ard4kocabiyik/kocapilot-kapgan-multi-domain-FCU/Docs/Kocapilot_Kapgan_SCH_Raporu.pdf

# Kocapilot Kapgan PCB Donanım Mimarisi, Sinyal Bütünlüğü, Matematiksel İspatlar, Komponent Analizi ve Şematik Düzeyde EMI/EMC Değerlendirme Raporu

Özet (Abstract) — Bu akademik teknik rapor; STM32F405RGT6 (U3) ana mikrodenetleyicisi [1], (https://www.st.com/resource/en/datasheet/dm00037051.pdf) [2] (https://www.st.com/resource/ja/reference_manual/dm00031020.pdf) ve Raspberry Pi Zero W (J1) yardımcı işlemci modülü [6], (https://www.raspberrypi.com/products/raspberry-pi-zero-w/) [7] (https://www.raspberrypi.org/app/uploads/2012/02/BCM2835-ARM-Peripherals.pdf) etrafında şekillenen gömülü uçuş/kontrol kartının donanım mimarisini, mantık seviyesi (logic level) uyumunu, sinyal bütünlüğü (Signal Integrity - SI) hesaplamalarını, birinci dereceden RC zaman sabiti ve yükselme süresi (tr

) matematiksel formül ispatlarını, pasif/aktif komponent seçim gerekçelerini ve şematik düzeyde elektromanyetik uyumluluk (EMI/EMC) ile elektrostatik deşarj (ESD) koruma
mimarisini | bütüncül | bir | mühendislik | perspektifiyle
incelemektedir. Tüm teknik iddialar, üretici veri sayfaları (datasheets), uygulama notları (application notes) ve uluslararası standartlarla IEEE numaralı atıf sistemine göre doğrulanmıştır.
I. Yönetici Özeti ve Sistem Mimarisi
Bu | teknik | rapor; | STM32F405RGT6 | (U3) | ana
mikrodenetleyicisi ve Raspberry Pi Zero W (J1) yardımcı işlemci modülü etrafında şekillenen gömülü kontrol kartının donanım mimarisini, sinyal bütünlüğü (Signal Integrity)
hesaplamalarını, | matematiksel | formül | ispatlarını,
elektromanyetik uyumluluk (EMI/EMC) önlemlerini ve komponent seçim gerekçelerini incelemektedir [1], (https://www.st.com/resource/en/datasheet/dm00037051.pdf) [2]. (https://www.st.com/resource/ja/reference_manual/dm00031020.pdf) Sistem; BMI270 (U1) 6-eksen eylemsel ölçüm birimi (SPI1) [8], (https://www.bosch-sensortec.com/media/boschsensortec/downloads/datasheets/bst-bmi270-ds000.pdf) MPU-6500 (U2) 6-eksen eylemsel ölçüm birimi (SPI2) [9], (https://product.tdk.com/en/search/sensor/mortion-inertial/imu/info?part_no=MPU-6500) MicroSD Kart Arayüzü (J5 - SPI3) [12], (https://users.ece.utexas.edu/~valvano/EE345M/SD_Physical_Layer_Spec.pdf) BMP280 (U5) barometrik basınç sensörü (I2C1) [10], (https://www.bosch-sensortec.com/media/boschsensortec/downloads/datasheets/bst-bmp280-ds001.pdf) SN65HVD230 (U8) CAN veriyolu alıcı-vericisi [14], (https://www.danomsk.ru/upload/iblock/507/129640_88c1a087ef01c473a9fb6655ddb2a31a.pdf) 74LVC1G86 (U7) kontrollü sinyal tersleyici [17] (https://assets.nexperia.com/documents/data-sheet/74LVC1G86.pdf) ve 74LVC1G125 (U9, U10, U11) üç durumlu (3-state) tampon/izolatör devrelerinden [16] (https://assets.nexperia.com/documents/data-sheet/74LVC1G125.pdf) oluşmaktadır. Güç katı ise çift kaynaklı (+5V VBUS ve 5V1 harici besleme) Schottky diyot (SS34) OR-ing mimarisi [26] (https://industrialmonitordirect.com/blogs/knowledgebase/servo-motor-pwm-control-wiring-power-and-microcontroller-code) ve 1.5 A kapasiteli LD39150DT33 (U6) doğrusal regülatörü (LDO) ile beslenmektedir [13]. (https://www.st.com/resource/en/datasheet/ld39150.pdf)

II. Sinyal Uyumu, Mantık Seviyesi (Logic Level) ve Sinyal

Tersleme (Inversion) Analizi

2.1. İşlemci ve Sensörler Arası Mantık Seviyesi (Logic Level) Uyumu
Tasarımda yer alan ana işlemci STM32F405RGT6 (U3) [1], (https://www.st.com/resource/en/datasheet/dm00037051.pdf) yardımcı işlemci Raspberry Pi Zero W (J1 - BCM2835 SoC) [6], (https://www.raspberrypi.com/products/raspberry-pi-zero-w/) [7] (https://www.raspberrypi.org/app/uploads/2012/02/BCM2835-ARM-Peripherals.pdf) ve tüm sensör/çevre birimleri (BMI270 [8], (https://www.bosch-sensortec.com/media/boschsensortec/downloads/datasheets/bst-bmi270-ds000.pdf) MPU-6500 [9], (https://product.tdk.com/en/search/sensor/mortion-inertial/imu/info?part_no=MPU-6500) BMP280 [10], (https://www.bosch-sensortec.com/media/boschsensortec/downloads/datasheets/bst-bmp280-ds001.pdf) SN65HVD230 [14], (https://www.danomsk.ru/upload/iblock/507/129640_88c1a087ef01c473a9fb6655ddb2a31a.pdf) MicroSD J5 [12]) (https://users.ece.utexas.edu/~valvano/EE345M/SD_Physical_Layer_Spec.pdf) 3.3V CMOS mantık seviyesinde (VDD = VDDIO = 3.3 V) çalışmaktadır. Her bir entegrenin giriş/çıkış voltaj eşikleri karşılaştırıldığında:
STM32F405RGT6 (U3, VDD = 3.3V): Maksimum düşük seviye giriş gerilimi VIL(max) = 0.3 × VDD = 0.99 V; minimum yüksek seviye giriş gerilimi VIH(min) = 0.7 × VDD = 2.31 V; maksimum düşük seviye çıkış gerilimi VOL(max) =

0.4 V; minimum yüksek seviye çıkış gerilimi VOH(min) = VDD − 0.4 V = 2.9 V [1]. (https://www.st.com/resource/en/datasheet/dm00037051.pdf)
BMI270 (U1, VDDIO = 3.3V): VIL(max) = 0.3 × VDDIO = 0.99 V; VIH(min) = 0.7 × VDDIO = 2.31 V; VOL(max) = 0.2 × VDDIO = 0.66 V; VOH(min) = 0.8 × VDDIO = 2.64 V [8]. (https://www.bosch-sensortec.com/media/boschsensortec/downloads/datasheets/bst-bmi270-ds000.pdf) MPU-6500 (U2, VDDIO = 3.3V): VIL(max) = 0.3 × VDDIO = 0.99 V; VIH(min) = 0.7 × VDDIO = 2.31 V; VOL(max) = 0.1 × VDDIO = 0.33 V; VOH(min) = 0.9 × VDDIO = 2.97 V [9]. (https://product.tdk.com/en/search/sensor/mortion-inertial/imu/info?part_no=MPU-6500) BMP280 (U5, VDDIO = 3.3V): VIL(max) = 0.2 × VDDIO = 0.66 V; VIH(min) = 0.8 × VDDIO = 2.64 V; VOL(max) = 0.2 × VDDIO = 0.66 V; VOH(min) = 0.8 × VDDIO = 2.64 V [10]. (https://www.bosch-sensortec.com/media/boschsensortec/downloads/datasheets/bst-bmp280-ds001.pdf)
Tüm sensörlerin VOH(min) değerleri (2.64 V – 2.97 V), işlemcinin VIH(min) eşiğinden (2.31 V) büyüktür ve en az 0.33 V yüksek seviye gürültü marjı (NMH = VOH(min) − VIH(min)) sağlar. Benzer şekilde VOL(max) değerleri (0.33 V – 0.66 V), alıcı VIL(max) eşiklerinin (0.66 V – 0.99 V) altındadır. Bu teknik uyum sebebiyle işlemci ile sensörler arasında gerilim seviyesi dönüştürücüye (level shifter) ihtiyaç duyulmamaktadır [1], (https://www.st.com/resource/en/datasheet/dm00037051.pdf) [8]– (https://www.bosch-sensortec.com/media/boschsensortec/downloads/datasheets/bst-bmi270-ds000.pdf) [10]. (https://www.bosch-sensortec.com/media/boschsensortec/downloads/datasheets/bst-bmp280-ds001.pdf)
2.2. Sinyal Tersleme (Inversion) Değerlendirmesi ve Gerekçelendirilmesi
A. Sensör, SPI, I2C, CAN ve Kesme (Interrupt) Hatları: Sinyal Terslemeye Gerek Yoktur
İşlemci (STM32F405RGT6) ile sensörler (BMI270, MPU-6500, BMP280), MicroSD (J5) ve CAN (U8) birimleri arasındaki SPI1, SPI2, SPI3, I2C1, CAN1 ve kesme (INT1, INT2, MPU_INT) hatlarında sinyal terslemeye gerek yoktur. Gerekçeleri şunlardır:
1. SPI | Polarite | ve | Faz | Uyumu | (CPOL/CPHA):
STM32F405RGT6 donanımsal SPI birimleri hem Mod 0 (CPOL = 0, CPHA = 0) hem de Mod 3 (CPOL = 1, CPHA = 1) saat polaritesini doğrudan destekler [2]. (https://www.st.com/resource/ja/reference_manual/dm00031020.pdf) Aktif-düşük (Active-Low) çalışan çip seçme pinleri (CSB, nCS, SD_NSS) işlemci GPIO pinleri tarafından doğrudan Lojik-0 seviyesine çekilerek sürülür ve R1, R5, R15, R66 (10 kΩ) pull-up dirençleri ile boşta Lojik-1 seviyesinde tutulur.
2. Kesme (Interrupt) Polaritesi: BMI270 (INT1, INT2) [8] (https://www.bosch-sensortec.com/media/boschsensortec/downloads/datasheets/bst-bmi270-ds000.pdf) ve MPU-6500 (INT) [9] (https://product.tdk.com/en/search/sensor/mortion-inertial/imu/info?part_no=MPU-6500) kesme çıkışları yazılımsal olarak
Aktif-Yüksek | (Active-High, | Push-Pull) | modda
yapılandırılmakta ve R4, R10, R19 (10 kΩ) pull-down
dirençleri | ile | boşta | Lojik-0 | (0 | V) | seviyesinde
sabitlenmektedir. STM32 EXTI birimi yükselen kenar (rising edge) tetiklemesine doğrudan duyarlı olduğundan harici sinyal terslemeye gerek yoktur [2]. (https://www.st.com/resource/ja/reference_manual/dm00031020.pdf)
3. I2C1 ve CAN1 Protokol Uyumu: BMP280 ile haberleşen I2C1 hattı açık-drenaj (open-drain) yapısında olup R8 ve R9 (2.2 kΩ) pull-up dirençleriyle doğrudan standart I2C mantığında çalışır [11]. SN65HVD230 CAN alıcı-vericisi ise resesif durumu Lojik-1 (3.3 V), dominant durumu Lojik-0 (0 V) olarak STM32 CAN1_TX / CAN1_RX donanımıyla birebir aynı polaritede işler [14].
B. Uzaktan Kumanda Girişi (RC_IN_UART) ve Tampon Yetkilendirme (OE) Hatları: Sinyal Terslemeye Gerek Vardır
1. RC_IN Hattında Kontrollü Tersleme (74LVC1G86 - U7 ve JP2): STM32F405RGT6 mimarisinde bulunan donanımsal UART alıcıları (PD2 / UART5_RX), dahili pin tersleme (hardware RX pin inversion) özelliğine sahip değildir [2]. (https://www.st.com/resource/ja/reference_manual/dm00031020.pdf) Standart UART protokolleri (CRSF, IBUS) boşta Lojik-1 (Idle-High) çalışırken, Futaba SBUS protokolü terslenmiş mantık (Inverted UART, boşta Lojik-0 / Idle-Low) kullanır. Bu donanımsal kısıt sebebiyle RC_IN hattında sinyal terslemeye gerek vardır. Çözüm olarak 74LVC1G86 (U7) tekli XOR kapısı [17] (https://assets.nexperia.com/documents/data-sheet/74LVC1G86.pdf) ve JP2 lehim jumper'ı kullanılmıştır. XOR doğruluk tablosuna göre (Y = A ⊕ B):
› JP2 üzerinden 1B girişi (Pin 2) Lojik-0 (GND) seviyesine bağlandığında: Y = A ⊕ 0 = A (Sinyal terslenmeden tampon olarak geçer; CRSF/IBUS uyumlu). › JP2 açık bırakılarak R30 (10 kΩ) pull-up direnciyle 1B girişi Lojik-1 (3.3 V) seviyesine çekildiğinde: Y = A ⊕ 1 = NOT(A) (Sinyal donanımsal olarak terslenir; SBUS uyumlu).
2. Güç İzolasyonu ve Tampon Yetkilendirme Hattı (2N7002
- Q2 ve 74LVC1G125 - U9): Raspberry Pi Zero W modülünün 3.3V besleme hattı (PI_3V3) aktif olduğunda (Lojik-1), 74LVC1G125 (U9) tampon entegresinin aktif-düşük yetkilendirme pini olan OE (Pin 1) girişinin Lojik-0 (GND) seviyesine çekilmesi gerekmektedir [16]. (https://assets.nexperia.com/documents/data-sheet/74LVC1G125.pdf) Aktif-yüksek güç varlık sinyalini (PI_3V3 = 3.3 V) aktif-düşük yetkilendirme sinyaline (OE = 0 V) dönüştürmek için sinyal terslemeye gerek vardır. Bu işlem Q2 (2N7002 N-Kanal MOSFET) [27], (https://assets.nexperia.com/documents/data-sheet/2N7002.pdf) R80 (100 kΩ pull-up) ve R81 (100 kΩ pull-
down) | tabanlı | evirici | anahtarlama | devresi | ile
gerçekleştirilmiştir:
Raspberry Pi Zero W enerjisizken (PI_3V3 = 0 V): R81 direnci Q2 Gate ucunu 0 V'da tutar, Q2 kesimdedir (OFF). R80 direnci U9 Pin 1 (OE) ucunu 3.3V_DIGI (Lojik-1) seviyesine çeker ve U9 çıkışı yüksek empedans (Hi-Z) modunda kalarak güç bölgeleri arası ters akım sızıntısını (back-powering) önler [16]. (https://assets.nexperia.com/documents/data-sheet/74LVC1G125.pdf)
Raspberry Pi Zero W enerjili iken (PI_3V3 = 3.3 V): Q2 Gate ucu 3.3 V olur (VGS = 3.3 V > VGS(th) = 1.8 V), Q2 iletime geçer (ON) ve U9 Pin 1 (OE) ucunu GND (Lojik-
0) seviyesine çekerek UART haberleşmesini aktif hale getirir [27]. (https://assets.nexperia.com/documents/data-sheet/2N7002.pdf)

III. Sinyal Bütünlüğü (Signal Integrity), Matematiksel

Türetimler ve Hat Hesaplamaları

3.1. RC Adım Yanıtı ve %10 - %90 Yükselme Süresi (tr = 2.2 × R × C) Matematiksel İspatı
Seri direnç (R) ve paralel yük kapasitansı (C) içeren birinci dereceden bir RC ağında, t = 0 anında uygulanan Vson genlikli birim basamak (step) gerilimine karşı kapasitör uçlarındaki anlık gerilim V(t) şu diferansiyel denklem çözümüyle ifade edilir (High-Speed Digital Design / AN4879) [5]: (https://www.st.com/resource/en/application_note/an4879-introduction-to-usb-hardware-and-pcb-guidelines-using-stm32-mcus-stmicroelectronics.pdf)

V(t) = Vson × (1 − e

−t / (R × C))
Burada zaman sabiti τ = R × C'dir. Sinyalin son değerinin %10'una (0.1 × Vson) ulaştığı an t1 ve %90'ına (0.9 × Vson) ulaştığı an t2 olarak tanımlandığında:
1. %10 Seviyesi (t1 Anı):
0.1 × Vson = Vson × (1 − e

−t1 / (R × C)) ⇒ 0.1 = 1 − e

−t1 / (R ×
C) ⇒ e

−t1 / (R × C) = 0.9
Her iki tarafın doğal logaritması (ln) alındığında:
−t1

/ (R × C) = ln(0.9) = −0.10536 ⇒ t1 = 0.10536 × R × C
2. %90 Seviyesi (t2 Anı):
0.9 × Vson = Vson × (1 − e

−t2 / (R × C)) ⇒ 0.9 = 1 − e

−t2 / (R ×
C) ⇒ e

−t2 / (R × C) = 0.1
Her iki tarafın doğal logaritması (ln) alındığında:
−t2

/ (R × C) = ln(0.1) = −2.302585 ⇒ t2 = 2.302585 × R × C
3. Yükselme Süresi (t

r = t2 − t1

):
tr = t2 − t1 = (2.302585 × R × C) − (0.10536 × R × C)
tr = R × C × (ln(10) − ln(10/9)) = R × C × ln(9)
ln(9) = 2.19722458 olup mühendislik hesaplamalarında 2.2 olarak kullanılır:
tr = 2.1972 × R × C ≈ 2.2 × R × C
3.2. SPI3 / MicroSD Kart (J5) Hattı Sinyal Bütünlüğü ve Harmonik Analizi
STM32F405RGT6 APB1 (42 MHz) veriyolu üzerinden sürülen SPI3 birimi, 2'ye bölme faktörü (prescaler = 2) ile fclk = 21 MHz saat frekansında çalışmaktadır [2], (https://www.st.com/resource/ja/reference_manual/dm00031020.pdf) [12]. (https://users.ece.utexas.edu/~valvano/EE345M/SD_Physical_Layer_Spec.pdf)
Periyot ve Darbe Genişliği:
T = 1 / fclk = 1 / (21 × 10

6 Hz) = 4.7619 × 10

−8 s = 47.62 ns
Simetrik (%50 görev döngülü) kare dalga için yarım periyot (Lojik-1 darbe genişliği):
Thalf = T / 2 = 47.62 ns / 2 = 23.81 ns
Hat Yük Kapasitansı (Cload) Bileşenleri:
Cload = Cpin (Alıcı giriş kapasitansı: 7 pF) + Ctrace (4–5 cm FR4 mikroşerit yol kapasitansı, ≈ 1 pF/cm: 5 pF) + Cconn (J5 soket ve ESD ped kapasitansı: 3 pF) = 7 pF + 5 pF + 3 pF = 15 pF (15 × 10

−12 F).
Karakteristik Empedans Eşleşmesi (Z0 = 50 Ω):
MCU Çıkış Yönü (SD_NSS → R62, SPI3_SCK → R63, SPI3_MOSI → R65): STM32 hızlı GPIO sürücü iç empedansı Rdrv = 28 Ω'dur [1]. (https://www.st.com/resource/en/datasheet/dm00037051.pdf) Rs = 22 Ω seri sönümleme direnci eklenerek toplam kaynak empedansı Ztoplam = Rdrv + Rs = 28 Ω + 22 Ω = 50 Ω değerine eşitlenmiş ve Z0 = 50 Ω PCB hattı ile tam empedans uyumu sağlanmıştır. MicroSD Kart Çıkış Yönü (J5 DAT0 → R64 → SPI3_MISO): MicroSD kart dahili sürücü çıkış empedansı Rdrv_card = 40 Ω'dur [12]. (https://users.ece.utexas.edu/~valvano/EE345M/SD_Physical_Layer_Spec.pdf) Hat empedansı Z0 = 50 Ω ile tam eşleşme sağlamak amacıyla R64 = 10 Ω seçilmiştir: Ztoplam = Rdrv_card + R64 = 40 Ω + 10 Ω = 50 Ω.
Yükselme Süresi (t
r

) ve Darbe Genişliği Oranı: tr = 2.1972 × Ztoplam × Cload = 2.1972 × 50 Ω × 15 × 10

−12
F = 1.6479 × 10

−9 s ≈ 1.65 ns
Oran = (tr

/ Thalf) × 100 = (1.65 ns / 23.81 ns) × 100 = %6.93
Yükselme süresi darbe genişliğinin %10 sınırının (%6.93 < %10) altında kaldığından kare dalga dikliği korunur ve kurulum/tutma (setup/hold) zamanlama hatası oluşmaz.

Alçak Geçiren Kesim Frekansı (f
c

) ve Fourier Harmonik
Analizi:
fc = 1 / (2 × π × Ztoplam × Cload) = 1 / (2 × 3.14159 × 50 × 15 × 10

−12) = 1 / (4.71239 × 10

−9) = 212.21 MHz
Fourier serisi açılımına göre 21 MHz kare dalganın tek harmonikleri:
1. Harmonik (Temel Frekans): 1 × 21 MHz = 21 MHz
3. Harmonik: 3 × 21 MHz = 63 MHz
5. Harmonik: 5 × 21 MHz = 105 MHz
7. Harmonik: 7 × 21 MHz = 147 MHz
9. Harmonik: 9 × 21 MHz = 189 MHz
Kesim frekansı (212.21 MHz), 9. harmoniğin (189 MHz) üzerindedir; ilk 9 harmonik zayıflamadan geçerken 212.21 MHz üstündeki yüksek frekanslı çınlama (ringing) ve aşım (overshoot) bileşenleri süzülür. Bu düzenleme sayesinde EMI/EMC direnci artırılmıştır [5]. (https://www.st.com/resource/en/application_note/an4879-introduction-to-usb-hardware-and-pcb-guidelines-using-stm32-mcus-stmicroelectronics.pdf)
3.3. SPI1 (BMI270 - U1) ve SPI2 (MPU-6500 - U2) Hatlarına Genişletilmiş Sinyal Analizi
SD kart (SPI3) hatları için uygulanan sinyal bütünlüğü modeli, kart üzerindeki noktadan noktaya (point-to-point) uzanan SPI1 ve SPI2 sensör veriyollarına genişletilmiştir:
A. SPI1 Veriyolu (STM32 PA4..PA7 ↔ BMI270 U1)
BMI270 maksimum fclk_spi1 = 10 MHz SPI saat frekansını destekler [8]. (https://www.bosch-sensortec.com/media/boschsensortec/downloads/datasheets/bst-bmi270-ds000.pdf)
Periyot ve Yarım Periyot: Tspi1 = 1 / (10 × 10

6 Hz) = 100
ns; Thalf_spi1 = 100 ns / 2 = 50 ns.
Hat Yük Kapasitansı (Cload_spi1): Konnektör içermeyen doğrudan PCB bağlantısında Cpin (BMI270/STM32: 5 pF) + Ctrace (2–3 cm kısa mikroşerit yol: 3 pF) + Cpad (2 pF) = 10 pF (10 × 10

−12 F).
Empedans, Yükselme Süresi ve Kritik Yol Uzunluğu: Doğrudan bağlantıda (Rs = 0 Ω, Rdrv = 28 Ω):
tr_spi1 = 2.1972 × Rdrv × Cload_spi1 = 2.1972 × 28 Ω × 10 × 10

−12 F = 0.615 ns ≈ 0.62 ns.
Oran = (0.62 ns / 50 ns) × 100 = %1.24 (< %10).
FR4 tabakasında sinyal yayılım hızı vp ≈ 15 cm/ns (gecikme tpd ≈ 66 ps/cm) olduğundan, 0.62 ns yükselme süresi için kritik iletim hattı uzunluğu Lkritik = (tr_spi1 / 2) × vp = 0.31 ns × 15 cm/ns = 4.65 cm'dir. BMI270 işlemciye < 2.5 cm mesafede konumlandırıldığından (Ltrace < Lkritik) hat "elektriksel olarak kısa" (lumped element) davranır ve yansıma oluşmaz. Kesim frekansı fc_spi1 = 1 / (2 × π × 28 × 10 × 10

−12) = 568.4 MHz olup 10 MHz saatin 55. harmoniğine kadar tam geçiş sağlar.
B. SPI2 Veriyolu (STM32 PB12..PB15 ↔ MPU-6500 U2) MPU-6500 yüksek hızlı SPI modunda maksimum fclk_spi2 = 20 MHz saat frekansında çalışır (STM32 APB1 42 MHz / 4 = 10.5 MHz nominal veya 20 MHz maksimum sınırda analiz edilmiştir) [9]. (https://product.tdk.com/en/search/sensor/mortion-inertial/imu/info?part_no=MPU-6500)
Periyot ve Yarım Periyot (fclk = 20 MHz için): Tspi2 = 1 / (20 × 10

6 Hz) = 50 ns; Thalf_spi2 = 50 ns / 2 = 25 ns.
Hat Yük Kapasitansı (Cload_spi2): QFN-24 kılıf giriş kapasitansı Cpin (7 pF) + Ctrace (3 cm yol: 3 pF) + Cpad (2 pF) = 12 pF (12 × 10

−12 F).

Yükselme Süresi ve Harmonik Analiz: Rdrv = 28 Ω sürücü empedansı ile:
tr_spi2 = 2.1972 × 28 Ω × 12 × 10

−12 F = 0.738 ns ≈ 0.74
ns.
Oran = (0.74 ns / 25 ns) × 100 = %2.96 (< %10).
Kesim frekansı fc_spi2 = 1 / (2 × π × 28 × 12 × 10

−12) =
473.7 MHz olup 20 MHz kare dalganın ilk 23 tek harmoniğini (23 × 20 MHz = 460 MHz) zayıflamasız iletir.
3.4. I2C1 Veriyolu (400 kHz Fast-Mode) Yükselme Süresi Türetimi ve Sönümleme Analizi
I2C açık-drenaj (open-drain) veriyolunda NXP UM10204 standardı, yükselme süresini VIL(max) = 0.3 × VDD seviyesinden VIH(min) = 0.7 × VDD seviyesine çıkış süresi olarak tanımlar [11]: (https://www.nxp.com/documents/user_manual/UM10204.pdf)
0.8473 Katsayısının Matematiksel İspatı:
V(t1

) = 0.3 × VDD ⇒ 1 − e

−t1 / (Rp × Cbus) = 0.3 ⇒ e

−t1 / (Rp ×
Cbus) = 0.7 ⇒ t1 = −Rp × Cbus × ln(0.7) = 0.356675 × Rp ×
Cbus
V(t2

) = 0.7 × VDD ⇒ 1 − e

−t2 / (Rp × Cbus) = 0.7 ⇒ e

−t2 / (Rp ×
Cbus) = 0.3 ⇒ t2 = −Rp × Cbus × ln(0.3) = 1.203973 × Rp ×
Cbus
tr = t2 − t1 = Rp × Cbus × (1.203973 − 0.356675) = Rp × Cbus × ln(0.7 / 0.3) = Rp × Cbus × ln(7/3) = 0.847298 × Rp × Cbus ≈ 0.8473 × Rp × Cbus

### 2.2 kΩ (R8, R9) ve 10 kΩ Karşılaştırması (Cbus = 150 pF

için):
Standart 10 kΩ pull-up kullanıldığında: tr = 0.8473 × 10000 × 150 × 10

−12 = 1270.95 ns (I2C Fast-Mode maksimum sınırı olan 300 ns değerini aşarak haberleşmeyi bozar). Tasarımda seçilen R8 = R9 = 2.2 kΩ ile: tr = 0.8473 × 2200 × 150 × 10

−12 = 279.61 ns (≤ 300 ns sınırını sağlar) [11]. (https://www.nxp.com/documents/user_manual/UM10204.pdf) Seri Sönümleme (R43, R44 = 22 Ω) ve ESD Koruması (PRTR5V0U2X - D10):
DB25 (J6) dış konnektörüne çıkan I2C1_SDA ve I2C1_SCL hatlarındaki 22 Ω seri dirençler, hat yansımalarını sönümler ve 3.3 V kısa devre anında tepe akımı I = 3.3 / 22 = 150 mA (P = 0.495 W) ile sınırlar. D10 (PRTR5V0U2X) yalnızca Cd = 1 pF parazitik kapasitans ekleyerek yükselme süresini bozmadan ESD koruması sağlar [20]. (https://www.nexperia.com/product/PRTR5V0U2X) Bu düzenleme sayesinde EMI/EMC direnci artırılmıştır.
3.5. USB 2.0 Diferansiyel Empedans, CC Güç Algılama ve CAN Bus Split Terminasyon Hesaplamaları
A. USB 2.0 Full-Speed (12 Mbps) Diferansiyel Hat Empedansı (R24, R25 = 22 Ω)
STM32F405RGT6 dahili USB PHY sürücü çıkış empedansı Rdrv ≈ 23 Ω'dur (AN4879) [5]. (https://www.st.com/resource/en/application_note/an4879-introduction-to-usb-hardware-and-pcb-guidelines-using-stm32-mcus-stmicroelectronics.pdf) D+ ve D− hatlarına seri eklenen R24 = R25 = 22 Ω dirençler ile:
Tek uçlu (Single-Ended) hat empedansı: Zse = Rdrv + Rs = 23 Ω + 22 Ω = 45 Ω.
Diferansiyel (Differential) hat empedansı: Zdiff = 2 × Zse = 2 × 45 Ω = 90 Ω.
USB 2.0 standardının şart koştuğu 90 Ω ± %15 diferansiyel mikroşerit empedansı tam olarak sağlanır [5]. (https://www.st.com/resource/en/application_note/an4879-introduction-to-usb-hardware-and-pcb-guidelines-using-stm32-mcus-stmicroelectronics.pdf) USBLC6-2SC6 (U4) ultra düşük kapasitanslı (< 3.5 pF) TVS dizisi ile sinyal bütünlüğü korunarak ESD darbeleri sönümlenir [24]. (https://www.st.com/resource/en/datasheet/usblc6-2.pdf)

B. USB Type-C CC1/CC2 Konfigürasyon Kanalı Gerilim Bölücü İspatı (R17, R18 = 5.1 kΩ)
Kartı UFP/Sink (güç alan) modunda tanımlayan Rd = 5.1 kΩ (R17, R18) pull-down dirençleri, güç kaynağı (Host/DFP) tarafındaki 5 V referanslı Rp pull-up direnciyle gerilim bölücü oluşturur:

VCC = VBUS_ref × (Rd

/ (Rp

+ Rd

))
Standart USB Gücü (900 mA, Rp = 56 kΩ): VCC = 5.0 × (5.1 / (56 + 5.1)) = 0.4173 V ≈ 0.418 V.
Orta Güç Modu (1.5 A, Rp = 22 kΩ): VCC = 5.0 × (5.1 / (22 + 5.1)) = 0.9410 V ≈ 0.941 V.
Yüksek Güç Modu (3.0 A, Rp = 10 kΩ): VCC = 5.0 × (5.1 / (10 + 5.1)) = 1.6887 V ≈ 1.688 V.
C. CAN Bus (1 Mbps) Split Terminasyon ve Ortak Mod (Common-Mode) Filtre Analizi
SN65HVD230 (U8) CAN_L ve CAN_H hatlarında R33 = 60.4 Ω ve R34 = 60.4 Ω (%1 toleranslı) dirençler ile orta noktadan toprağa bağlı C34 = 4.7 nF kapasitörden oluşan Split Terminasyon kullanılmıştır (TI SLLA270) [14], (https://www.danomsk.ru/upload/iblock/507/129640_88c1a087ef01c473a9fb6655ddb2a31a.pdf) [15]: (https://www.ti.com/lit/pdf/slla270) Diferansiyel Empedans: Zdiff_CAN = R33 + R34 = 60.4 Ω + 60.4 Ω = 120.8 Ω (ISO 11898-2 Z0 = 120 Ω bükümlü çift kablo ile tam uyum).
Ortak Mod (Common-Mode) Kesim Frekansı: Ortak mod gürültüleri için R33 ve R34 paralel davranır:
Rcm = (R33 × R34) / (R33 + R34) = 60.4 / 2 = 30.2 Ω.
C34 = 4.7 nF ile oluşturulan alçak geçiren ortak mod filtresinin kesim frekansı:
fc_CAN = 1 / (2 × π × Rcm × C34) = 1 / (2 × 3.14159 × 30.2 Ω × 4.7 × 10

−9 F) = 1.121 MHz ≈ 1.12 MHz. Bu düzenleme sayesinde diferansiyel CAN sinyali bozulmadan 1.12 MHz üzerindeki ortak mod RF/EMI gürültüleri toprağa süzülür ve EMI/EMC direnci artırılmıştır [15]. (https://www.ti.com/lit/pdf/slla270)

3.6. UART, GPIO ve PWM Hatları Sinyal ve Akım Sınırlama Analizi
DB25 (J6) Harici UART ve PWM Koruma Hatları (R46– R57 = 150 Ω, R45 = 100 Ω):
Harici | konnektöre | çıkan | TIM8_CH1..CH4,
TIM3_CH3..CH4, USART2 (TX, RX, RTS, CTS), USART3_TX ve RC_IN hatlarında 150 Ω seri dirençler kullanılmıştır. 3.3 V kısa devre durumunda maksimum akım I = 3.3 V / 150 Ω = 22 mA (STM32 pin başına 25 mA mutlak sınırının altında [1]) (https://www.st.com/resource/en/datasheet/dm00037051.pdf) ve direnç üzerindeki güç P = 3.3

2
/ 150 = 72.6 mW (0603 kılıf 100 mW sınırının altında) olarak sınırlandırılır. USART3_RX (R45 = 100 Ω) hattında ise 5 V aşırı gerilim darbesinde akım I = 5 V / 100 Ω = 50 mA ve güç P = 5
| 2
/ 100 = 0.25 W ile sınırlanarak ESDA6V1-5SC6 (D12–D14) TVS diyotlarıyla birlikte giriş pini korunur [23]. (https://www.st.com/resource/en/datasheet/esda6v1-5sc6.pdf)
Raspberry Pi Zero W (J1) - STM32 UART ve GPIO Arayüzü (R13, R14 = 100 Ω; R74 = 470 Ω):
J1 Pin 8 (TXD) ve Pin 10 (RXD) hatlarındaki 100 Ω seri dirençler 3.3 V kısa devrede akımı I = 3.3 / 100 = 33 mA ile sınırlar. GPIO_MCU ile U10 (Pin 2) arasındaki R74 = 470 Ω seri direnç ise olası hata akımını I = 3.3 / 470 = 7.02 mA ve harcanan gücü P = 3.3

2
/ 470 = 23.17 mW ≈ 23.2 mW seviyesinde tutar.
3.7. Kristal Osilatör (HSE 8 MHz) Yük Kapasitansı ve Sürüş Seviyesi (Drive Level) Hesabı
STM32F405RGT6 OSC_IN (Pin 5) ve OSC_OUT (Pin 6) bacaklarına bağlı Y1 (Abracon ABM8-8.000MHZ-10-B2-T) kristali için hedeflenen yük kapasitansı CL = 10 pF'dir (AN2867) [4], (https://www.st.com/resource/en/application_note/an2867-guidelines-for-oscillator-design-on-stm8afals-and-stm32-mcusmpus-stmicroelectronics.pdf) [19]: (https://abracon.com/Resonators/abm8.pdf)
Yük Kapasitansı Doğrulaması (C25 = C26 = 12 pF, C0G/NP0):
PCB yolları ve MCU pinlerinin toplam kaçak kapasitansı Cstray = 4 pF alındığında:
CL = ((C25 × C26) / (C25 + C26)) + Cstray = ((12 × 12) / (12 + 12)) + 4 = (144 / 24) + 4 = 6 pF + 4 pF = 10 pF. Sürüş Seviyesi (Drive Level) ve R26 (100 Ω) Sönümleme Direnci:
Kristal üzerinde harcanan güç DL = IRMS

2 × ESR
bağıntısıyla hesaplanır. OSC_OUT çıkışına seri bağlanan R26 = 100 Ω direnç, kristalin maksimum 100 μW sürüş sınırını aşmasını (overdriving) önler, mekanik yaşlanmayı ve frekans kaymasını (drift) engeller [4], (https://www.st.com/resource/en/application_note/an2867-guidelines-for-oscillator-design-on-stm8afals-and-stm32-mcusmpus-stmicroelectronics.pdf) [19]. (https://abracon.com/Resonators/abm8.pdf)

IV. Aktif Entegreler ve İşlemci Modülleri: Seçim Gerekçeleri

ve Pin Analizleri

4.1. U3 - STM32F405RGT6 Ana Mikrodenetleyici (LQFP-64) Teknik Seçim Gerekçesi: 168 MHz ARM Cortex-M4F çekirdeği, donanımsal tek duyarlıklı kayan nokta birimi (FPU), DSP komut seti, 1 MB Flash, 192 KB SRAM ve eşzamanlı 3x SPI, 3x USART/UART, 1x CAN, 1x I2C, USB 2.0 OTG FS ile gelişmiş PWM zamanlayıcı (TIM3, TIM8) gereksinimlerini tek çipte karşılaması sebebiyle bu komponent tercih edilmiştir [1], (https://www.st.com/resource/en/datasheet/dm00037051.pdf) [2]. (https://www.st.com/resource/ja/reference_manual/dm00031020.pdf)
EMI/EMC Önlemi: Her bir VDD pini (Pin 19, 32, 48, 64) 100 nF (C2, C3, C6, C7) seramik kapasitörlerle doğrudan dekuple edilmiş, analog besleme (VDDA - Pin 13) FB1 ferrit boncuğu ve C5/C8/C9 filtre ağı ile dijital gürültüden izole edilmiştir; bu düzenleme sayesinde EMI/EMC direnci artırılmıştır (AN4488) [3]. (https://www.alldatasheet.com/datasheet-pdf/pdf/701384/STMICROELECTRONICS/AN4488.html)

Tablo 1: U3 - STM32F405RGT6 (LQFP-64) Pin Dağılımı, Şematik Sinyal Hatları ve Eksiksiz Fonksiyonel Analizi [1]– (https://www.st.com/resource/en/datasheet/dm00037051.pdf)[5]. (https://www.st.com/resource/en/application_note/an4879-introduction-to-usb-hardware-and-pcb-guidelines-using-stm32-mcus-stmicroelectronics.pdf)

Pin
No
| Pin Adı | Şematik Sinyal Hattı
Yön / Tip | Fonksiyonel Açıklama ve
| | | Bağlantı Detayı (Tam Metin)
1 | VBAT | 3.3V_DIGI (C1 10μF ile)
Güç Girişi | RTC ve yedekleme
| | | kayıtçıları (backup registers) besleme girişi; C1 (10μF) ile lokal olarak dekuple edilmiştir.
2 | PC13 | BUZZER | Dijital Çıkış R31 (1kΩ) seri kapı direnci üzerinden Q1 (AO3400A) MOSFET'ini sürerek 5V endüktif Buzzer (J3) yükünü anahtarlar.
3, 4 | PC14, PC15 | NC | Boş Bacak Kullanılmayan LSE (32.768 kHz) düşük hızlı kristal osilatör / GPIO bacakları; parazitik kuplajı önlemek için açık (NC) bırakılmıştır.
5 | PH0 / OSC_IN | OSC_IN (Y1, C25 12pF) | Analog Saat Girişi 8.000 MHz harici kristal osilatör (Y1) giriş bacağı; C25 (12pF C0G/NP0) yük kapasitörü ile toprağa bağlanmıştır.

Pin
No
| Pin Adı | Şematik Sinyal Hattı
Yön / Tip | Fonksiyonel Açıklama ve
Bağlantı Detayı (Tam
Metin)
6 | PH1 / OSC_OUT | OSC_OUT (R26 100Ω, Y1, C26) | Analog Saat Çıkışı

8.000 MHz harici kristal
osilatör (Y1) çıkış bacağı; R26 (100Ω) sürüş sınırlama direnci ve C26 (12pF
C0G/NP0) ile bağlanmıştır.
7 | NRST | NRST (R2 10kΩ, C4 0.1μF, SW1) | Reset Girişi/Çıkışı

Aktif-düşük donanımsal
sistem reset pini; R2 (10kΩ) pull-up, C4 (0.1μF) ark/EFT süzme kapasitörü ve SW1
butonu bağlıdır.
8 | PC0 | MPU_INT (R19 10kΩ Pull- Down) | Dijital Giriş (EXTI0)

MPU-6500 (U2) veri hazır
(Data Ready) aktif-yüksek
kesme girişi; R19 (10kΩ) ile boşta Lojik-0'a
sabitlenmiştir.
9, 11 PC1, PC3 | NC | Boş Bacak Kullanılmayan genel amaçlı
GPIO bacakları; dış gürültü kapmaması için açık (NC)
bırakılmıştır.
10 | PC2 | SD_NSS (R62 22Ω, R66 10kΩ) | Dijital Çıkış (GPIO CS)

MicroSD kart (J5) SPI3
aktif-düşük çip seçme (CS) hattı; R62 (22Ω) empedans
eşleme ve R66 (10kΩ) pull-up içerir.
12 | VSSA | GND | Analog Toprak

Dahili ADC/DAC ve
PLL/analog çeviriciler için sessiz analog referans
toprağı (GND düzlemine
bağlı).
13 | VDDA | VDDA (FB1, C5 1μF, C8/C9 0.1μF) | Analog Güç Girişi

FB1 ferrit boncuk ve C5
(1μF) + C8/C9 (0.1μF) Pi-tipi filtre ağı ile yüksek frekanslı dijital gürültüden izole edilmiş analog
besleme.
14 | PA0 | USART2_CTS (R55 150Ω, R71 10kΩ) | Dijital Giriş (AF7)

USART2 donanımsal akış
kontrolü (Clear-To-Send)
girişi; DB25 (J6 Pin 12)
konnektörüne R55 (150Ω)
ve D14 TVS üzerinden
bağlanır.
15 | PA1 | USART2_RTS (R53 150Ω, R73 10kΩ) | Dijital Çıkış (AF7)

USART2 donanımsal akış
kontrolü (Request-To-Send) çıkışı; DB25 (J6 Pin 11)
konnektörüne R53 (150Ω),
R73 (10kΩ) pull-up ve D14
TVS ile çıkar.
16 | PA2 | USART2_TX (R49 150Ω, R75 10kΩ) | Dijital Çıkış (AF7)

USART2 seri veri gönderme
(TX) hattı; R49 (150Ω) akım sınırlama direnci, R75
(10kΩ) pull-up ve D13 TVS
ile DB25 (J6 Pin 9) hattını sürer.
17 | PA3 | USART2_RX (R51 150Ω, R76 10kΩ) | Dijital Giriş (AF7)

USART2 seri veri alma (RX) hattı; R51 (150Ω) koruma
direnci, R76 (10kΩ) pull-up ve D13 TVS ile DB25 (J6
Pin 10) üzerinden okunur.
18, 63 VSS | GND | Dijital
| | | Toprak

Ana dijital toprak dönüş
bacakları; düşük endüktanslı via'larla doğrudan kesintisiz GND referans düzlemine
bağlanmıştır.

19,

32, 48, 64 | VDD | 3.3V_DIGI (C2, C3, C6, C7 0.1μF) | Dijital Güç Girişi

Dört ana dijital I/O ve dahili regülatör besleme pini; her biri pina en yakın noktada 0.1μF X7R kapasitörle
dekuple edilmiştir.

Pin
No
| Pin Adı | Şematik Sinyal Hattı
Yön / Tip | Fonksiyonel Açıklama ve
Bağlantı Detayı (Tam
Metin)
20 | PA4 | SPI1_NSS (R1 10kΩ Pull-Up) | Dijital Çıkış (GPIO CS)

BMI270 (U1) SPI1 aktif-düşük çip seçme (CSB - Pin
12) çıkışı; R1 (10kΩ) ile
açılışta Lojik-1 seviyesinde tutulur.
21 | PA5 | SPI1_SCK | Dijital Çıkış (AF5)

BMI270 (U1) için 10 MHz
SPI1 seri saat sinyali (SCX -Pin 13) çıkışı.
22 | PA6 | SPI1_MISO | Dijital Giriş (AF5)

BMI270 (U1) SDO (Pin 1)
bacağından gelen SPI1
Master-In Slave-Out seri veri girişi.
23 | PA7 | SPI1_MOSI | Dijital Çıkış (AF5)

BMI270 (U1) SDX (Pin 14)
bacağına giden SPI1 Master-Out Slave-In seri veri çıkışı.
24 | PC4 | BMI270_INT2 (R10 10kΩ Pull- Down) | Dijital Giriş (EXTI4)

BMI270 (U1) ikincil kesme
girişi (Pin 9); R10 (10kΩ) pull-down direnci ile boşta Lojik-0 seviyesinde
sabitlenir.
25 | PC5 | BMI270_INT1 (R4 10kΩ Pull- Down) | Dijital Giriş (EXTI5)

BMI270 (U1) birincil kesme girişi (Pin 4); R4 (10kΩ)
pull-down direnci ile boşta Lojik-0 seviyesinde
sabitlenir.
26 | PB0 | TIM3_CH3 (R41 10kΩ, R54 150Ω) | Dijital Çıkış (AF2 PWM)

Timer 3 Kanal 3 PWM
çıkışı; R41 (10kΩ) güvenli başlangıç pull-down ve R54 (150Ω) seri koruma ile
DB25 (J6 Pin 24) hattını
sürer.
27 | PB1 | TIM3_CH4 (R42 10kΩ, R56 150Ω) | Dijital Çıkış (AF2 PWM)

Timer 3 Kanal 4 PWM
çıkışı; R42 (10kΩ) güvenli başlangıç pull-down ve R56 (150Ω) seri koruma ile
DB25 (J6 Pin 25) hattını
sürer.
28 | PB2 / BOOT1 | BOOT1 (R16 10kΩ Pull- Down) | Dijital Giriş Sistem önyükleme (BOOT1
= 0) konfigürasyon pini; R16 (10kΩ) pull-down ile
toprağa çekilerek ana Flash önyüklemesi seçilir.
29 | PB10 | USART3_TX (R57 150Ω, R68 10kΩ) | Dijital Çıkış (AF7)

USART3 seri veri gönderme
(TX) hattı; R57 (150Ω) seri koruma, R68 (10kΩ) pull-up ve D14 TVS ile DB25 (J6
Pin 13) konnektörüne çıkar.
30 | PB11 | USART3_RX (R45 100Ω, R70 10kΩ) | Dijital Giriş (AF7)

USART3 seri veri alma (RX) hattı; R45 (100Ω) akım
sınırlama, R70 (10kΩ) pull-up ve D12 TVS ile DB25 (J6 Pin 14) üzerinden alınır.
31, 47 VCAP_1,
| VCAP_2 | C21 (2.2μF), C22 (2.2μF) → GND | Regülatör Çıkışı

Dahili 1.2V çekirdek LDO
regülatörünün kararlılık ve filtre çıkışları; düşük ESR'li (<2Ω) 2.2μF X7R
kapasitörlerle toprağa
bağlanır.
33 | PB12 | SPI2_NSS (R15 10kΩ Pull-Up) | Dijital Çıkış (GPIO CS)

MPU-6500 (U2) SPI2 aktif-düşük çip seçme (nCS - Pin
22) çıkışı; R15 (10kΩ) ile açılışta Lojik-1'de tutulur.
34 | PB13 | SPI2_SCK | Dijital Çıkış (AF5)

MPU-6500 (U2) için 20
MHz SPI2 seri saat sinyali (SCLK - Pin 23) çıkışı.
35 | PB14 | SPI2_MISO | Dijital Giriş (AF5)

MPU-6500 (U2) SDO/AD0
(Pin 9) bacağından gelen
SPI2 Master-In Slave-Out
seri veri girişi.

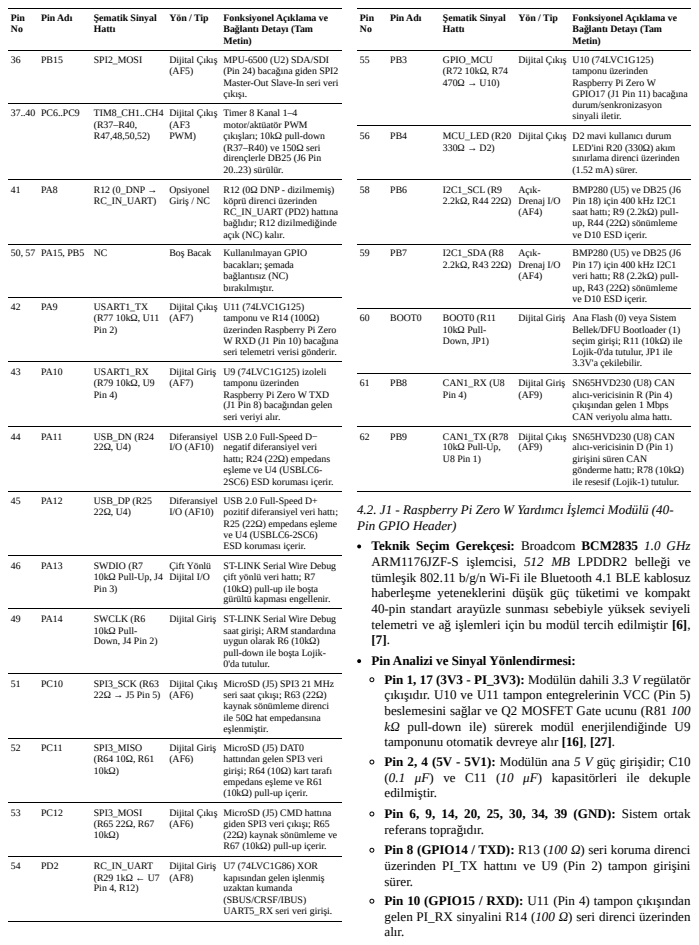
[picture p8: page 6]

Bağlantı Detayı (Tam
Metin)
MPU-6500 (U2) SDA/SDI
(Pin 24) bacağına giden SPI2
Master-Out Slave-In seri veri
çıkışı.
Timer 8 Kanal 1–4
motor/aktüatör PWM
çıkışları; 10kΩ pull-down
(R37–R40) ve 150Ω seri
dirençlerle DB25 (J6 Pin
20..23) sürülür.
R12 (0Ω DNP - dizilmemiş)
köprü direnci üzerinden
RC_IN_UART (PD2) hattına
bağlıdır; R12 dizilmediğinde
açık (NC) kalır.

Dijital Çıkış D2 mavi kullanıcı durum

bacakları; şemada
bağlantısız (NC)
bırakılmıştır.
U11 (74LVC1G125)
tamponu ve R14 (100Ω)
üzerinden Raspberry Pi Zero
W RXD (J1 Pin 10) bacağına
seri telemetri verisi gönderir.
U9 (74LVC1G125) izoleli
tamponu üzerinden
Raspberry Pi Zero W TXD
(J1 Pin 8) bacağından gelen
seri veriyi alır.
USB 2.0 Full-Speed D−
negatif diferansiyel veri
hattı; R24 (22Ω) empedans
eşleme ve U4 (USBLC6-
2SC6) ESD koruması içerir.
USB 2.0 Full-Speed D+
pozitif diferansiyel veri hattı;
R25 (22Ω) empedans eşleme
ve U4 (USBLC6-2SC6)
ESD koruması içerir.
ST-LINK Serial Wire Debug
çift yönlü veri hattı; R7
(10kΩ) pull-up ile boşta
gürültü kapması engellenir.

Dijital Giriş Ana Flash (0) veya Sistem

Bellek/DFU Bootloader (1)
seçim girişi; R11 (10kΩ) ile
Lojik-0'da tutulur, JP1 ile
3.3V'a çekilebilir.
SN65HVD230 (U8) CAN
alıcı-vericisinin R (Pin 4)
çıkışından gelen 1 Mbps
CAN veriyolu alma hattı.
alıcı-vericisinin D (Pin 1)
girişini süren CAN
gönderme hattı; R78 (10kΩ)
ile resesif (Lojik-1) tutulur.

4.2. J1 - Raspberry Pi Zero W Yardımcı İşlemci Modülü (40-
Pin GPIO Header)
Teknik Seçim Gerekçesi: Broadcom BCM2835 1.0 GHz
ARM1176JZF-S işlemcisi, 512 MB LPDDR2 belleği ve
tümleşik 802.11 b/g/n Wi-Fi ile Bluetooth 4.1 BLE kablosuz
haberleşme yeteneklerini düşük güç tüketimi ve kompakt
40-pin standart arayüzle sunması sebebiyle yüksek seviyeli
telemetri ve ağ işlemleri için bu modül tercih edilmiştir [6], (https://www.raspberrypi.com/products/raspberry-pi-zero-w/)
Pin Analizi ve Sinyal Yönlendirmesi:
Pin 1, 17 (3V3 - PI_3V3): Modülün dahili 3.3 V regülatör
çıkışıdır. U10 ve U11 tampon entegrelerinin VCC (Pin 5)
beslemesini sağlar ve Q2 MOSFET Gate ucunu (R81 100
kΩ pull-down ile) sürerek modül enerjilendiğinde U9
tamponunu otomatik devreye alır [16], (https://assets.nexperia.com/documents/data-sheet/74LVC1G125.pdf) [27]. (https://assets.nexperia.com/documents/data-sheet/2N7002.pdf)
Pin 2, 4 (5V - 5V1): Modülün ana 5 V güç girişidir; C10
(0.1 μF) ve C11 (10 μF) kapasitörleri ile dekuple
edilmiştir.
Pin 6, 9, 14, 20, 25, 30, 34, 39 (GND): Sistem ortak
referans toprağıdır.
Pin 8 (GPIO14 / TXD): R13 (100 Ω) seri koruma direnci
üzerinden PI_TX hattını ve U9 (Pin 2) tampon girişini
sürer.
Pin 10 (GPIO15 / RXD): U11 (Pin 4) tampon çıkışından
gelen PI_RX sinyalini R14 (100 Ω) seri direnci üzerinden
alır.

Dijital Giriş ST-LINK Serial Wire Debug

saat girişi; ARM standardına
uygun olarak R6 (10kΩ)
pull-down ile boşta Lojik-
0'da tutulur.
MicroSD (J5) SPI3 21 MHz
seri saat çıkışı; R63 (22Ω)
kaynak sönümleme direnci
ile 50Ω hat empedansına
eşlenmiştir.
MicroSD (J5) DAT0
hattından gelen SPI3 veri
girişi; R64 (10Ω) kart tarafı
empedans eşleme ve R61
(10kΩ) pull-up içerir.
MicroSD (J5) CMD hattına
giden SPI3 veri çıkışı; R65
(22Ω) kaynak sönümleme ve
R67 (10kΩ) pull-up içerir.
U7 (74LVC1G86) XOR
kapısından gelen işlenmiş
uzaktan kumanda
(SBUS/CRSF/IBUS)
UART5_RX seri veri girişi.

Pin 11 (GPIO17): U10 (Pin 4) tampon çıkışından gelen GPIO_ZERO durum/kontrol sinyalini okur.
Bağlantısız (NC) Pinler: Pin 3, 5, 7, 12, 13, 15, 16, 18, 19, 21, 22, 23, 24, 26, 27, 28, 29, 31, 32, 33, 35, 36, 37, 38, 40 şemada kullanılmadığından açık (NC) bırakılmıştır.
4.3. U1 - Bosch BMI270 6-Eksen Akıllı IMU Sensörü (LGA-14) Teknik Seçim Gerekçesi: 16-bit çözünürlüklü 3-eksen ivmeölçer ve 3-eksen jiroskop yapısını ultra düşük sıcaklık kayması ve dahili titreşim bastırma filtreleriyle sunması sebebiyle birincil ataletsel ölçüm sensörü olarak tercih edilmiştir [8]. (https://www.bosch-sensortec.com/media/boschsensortec/downloads/datasheets/bst-bmi270-ds000.pdf)
Pin Analizi: Pin 1 (SDO → SPI1_MISO), Pin 2–3 (ASDX, ASCX → NC), Pin 4 (INT1 → R4 10 kΩ Pull-Down ile PC5), Pin 5 (VDDIO → 3.3V_DIGI, C12 0.1 μF ile), Pin 6– 7 (GNDIO, GND → GND), Pin 8 (VDD → FB2, C13 1 μF ve C14 0.1 μF üzerinden 3.3V_DIGI), Pin 9 (INT2 → R10 10 kΩ Pull-Down ile PC4), Pin 10 (OCSB → R5 10 kΩ Pull-Up ile 3.3V_DIGI, ikincil OIS arayüzü pasif), Pin 11 (OSDO → R3 10 kΩ Pull-Down ile GND), Pin 12 (CSB → R1 10 kΩ Pull-Up ile SPI1_NSS), Pin 13 (SCX → SPI1_SCK), Pin 14 (SDX → SPI1_MOSI) [8]. (https://www.bosch-sensortec.com/media/boschsensortec/downloads/datasheets/bst-bmi270-ds000.pdf)
4.4. U2 - TDK InvenSense MPU-6500 6-Eksen IMU Sensörü (QFN-24)
Teknik Seçim Gerekçesi: 20 MHz yüksek hızlı SPI arayüzü, 4 KB FIFO belleği ve bağımsız bir MEMS mimarisiyle yedekli (redundant) sensör füzyonuna imkan tanıması sebebiyle ikincil IMU olarak tercih edilmiştir [9]. (https://product.tdk.com/en/search/sensor/mortion-inertial/imu/info?part_no=MPU-6500) Pin Analizi: Pin 1–6, 14–17, 19 (NC/RESV → Boş), Pin 7, 21 (AUX_CL, AUX_DA → NC), Pin 8 (VDDIO → 3.3V_DIGI, C15 0.1 μF ile), Pin 9 (SDO/AD0 → SPI2_MISO), Pin 10 (REGOUT → C18 0.1 μF ile GND, dahili LDO filtresi), Pin 11 (FSYNC → GND, gürültü kapmasını önlemek için toprağa sabitlenmiştir), Pin 12 (INT → R19 10 kΩ Pull-Down ile PC0), Pin 13 (VDD → FB3, C19 1 μF ve C20 10 nF üzerinden 3.3V_DIGI), Pin 18, 20, 25 (GND, Termal Ped ve RESV → GND), Pin 22 (nCS → R15 10 kΩ Pull-Up ile SPI2_NSS), Pin 23 (SCLK → SPI2_SCK), Pin 24 (SDI → SPI2_MOSI) [9]. (https://product.tdk.com/en/search/sensor/mortion-inertial/imu/info?part_no=MPU-6500)
4.5. U5 - Bosch BMP280 Dijital Barometrik Basınç Sensörü (LGA-8)
Teknik Seçim Gerekçesi: ±0.12 hPa (±1 m irtifa eşdeğeri) bağıl doğruluk ve 2.7 μA (@ 1 Hz) düşük akım tüketimiyle hassas irtifa hesabı sağlaması sebebiyle tercih edilmiştir [10]. (https://www.bosch-sensortec.com/media/boschsensortec/downloads/datasheets/bst-bmp280-ds001.pdf)
Pin Analizi (Düzeltilmiş Donanım Konfigürasyonu): Pin 1, 7 (GND): Toprak referansı.
Pin 2 (CSB): I2C haberleşme modunun aktif kalması için FB4 sonrasında 3.3V_DIGI (VDD/VDDIO) hattına bağlanmıştır. (Teknik Düzeltme Notu: BMP280'de CSB pini GND'ye çekilirse I2C arayüzü kalıcı olarak devre dışı kalır ve çip SPI moduna kilitlenir; SDI/SCK pinleri I2C1_SDA ve I2C1_SCL hatlarına bağlı olduğundan CSB pini Lojik-1 seviyesinde tutulmalıdır [10]). (https://www.bosch-sensortec.com/media/boschsensortec/downloads/datasheets/bst-bmp280-ds001.pdf)
Pin 3 (SDI): I2C1_SDA çift yönlü veri hattı.
Pin 4 (SCK): I2C1_SCL seri saat hattı.

Pin 5 (SDO): I2C 7-bit cihaz adresini 0x76 olarak sabitlemek için GND hattına bağlanmıştır [10]. (https://www.bosch-sensortec.com/media/boschsensortec/downloads/datasheets/bst-bmp280-ds001.pdf)
Pin 6 (VDD) ve Pin 8 (VDDIO): FB4 ferrit boncuğu sonrasında C24 (0.1 μF, VDD) ve C23 (0.1 μF, VDDIO) dekuplaj kapasitörleri ile 3.3V_DIGI hattından beslenir.
4.6. U6, U7, U8, U9, U10 ve U11 Yardımcı Entegrelerinin Analizi
U6 - LD39150DT33 (TO-252-3 / DPAK 1.5A LDO Regülatör): Tüm 3.3V_DIGI hattını ve ani akım çeken MicroSD/sensör bloklarını yüksek akım kapasitesi (1.5 A) ve ultra düşük dropout gerilimi (200 mV tipik, 0.4 V max) ile beslemek amacıyla tercih edilmiştir [13]. (https://www.st.com/resource/en/datasheet/ld39150.pdf) Pin 1 (VI → +5V, TP2, C29 4.7 μF ve C30 0.1 μF ile), Pin 2 (GND), Pin 3 (VO → 3.3V_DIGI, C31 10 μF ve C32 0.1 μF ile).
U7 - 74LVC1G86 (SOT-23-5 Tekli XOR Kapısı): RC_IN sinyalini JP2 jumper durumuna göre evirmek (SBUS) veya düz geçirmek (CRSF/IBUS) amacıyla tercih edilmiştir [17]. (https://assets.nexperia.com/documents/data-sheet/74LVC1G86.pdf) Pin 1 (1A → RC_IN, R28 10 kΩ Pull-Down), Pin 2 (1B → JP2 ve R30 10 kΩ Pull-Up), Pin 3 (GND), Pin 4 (1Y → R29 1 kΩ üzerinden PD2 / RC_IN_UART), Pin 5 (VCC → 3.3V_DIGI, C28 0.1 μF ile).
U8 - SN65HVD230 (SOIC-8 3.3V CAN Transceiver): 3.3 V mantık seviyesiyle doğrudan çalışan, 1 Mbps hız ve ±16 kV HBM ESD koruması sunan ISO 11898-2 fiziksel katman sürücüsü olması sebebiyle tercih edilmiştir [14]. (https://www.danomsk.ru/upload/iblock/507/129640_88c1a087ef01c473a9fb6655ddb2a31a.pdf) Pin 1 (D → CAN1_TX, R78 10 kΩ Pull-Up), Pin 2 (GND), Pin 3 (VCC → 3.3V_DIGI, C33 0.1 μF ile), Pin 4 (R → CAN1_RX), Pin 5 (Vref → NC), Pin 6 (CANL → R33 60.4 Ω, CR1), Pin 7 (CANH → R34 60.4 Ω, CR1), Pin 8 (Rs → R35 0 Ω ile GND, High-Speed mod).
U9, U10, U11 - 74LVC1G125 (SOT-23-5 3-Durumlu Tampon Entegreleri): STM32 (3.3V_DIGI) ile Raspberry Pi Zero W (PI_3V3) güç bölgeleri arasında kısmi güç kapatma (partial power-down / Ioff) izolasyonu sağlamak ve kapalı olan modüle I/O pinleri üzerinden kaçak akım akmasını önlemek amacıyla tercih edilmiştir [16]: (https://assets.nexperia.com/documents/data-sheet/74LVC1G125.pdf)
U9 (Pi TX → MCU RX): Pin 1 (OE → Q2 Drain ve R80 100 kΩ Pull-Up; yalnızca Pi açıkken aktif), Pin 2 (A → PI_TX, R69 10 kΩ Pull-Up), Pin 3 (GND), Pin 4 (Y → USART1_RX, R79 10 kΩ Pull-Up), Pin 5 (VCC → 3.3V_DIGI, C42 0.1 μF ile).
U10 (MCU GPIO → Pi GPIO17): Pin 1 (OE → GND), Pin 2 (A → GPIO_MCU, R72 10 kΩ Pull-Down ve R74 470 Ω seri), Pin 3 (GND), Pin 4 (Y → GPIO_ZERO / J1 Pin 11), Pin 5 (VCC → PI_3V3, C43 0.1 μF ile).
U11 (MCU TX → Pi RX): Pin 1 (OE → GND), Pin 2 (A → USART1_TX, R77 10 kΩ Pull-Up), Pin 3 (GND), Pin 4 (Y → PI_RX, R14 100 Ω üzerinden), Pin 5 (VCC → PI_3V3, C44 0.1 μF ile).
V. Pasif, Koruma ve Yarı İletken Komponentlerin Detaylı

Analizi ve Hesaplamaları

5.1. Kapasitörler (C1 - C44): Dekuplaj, Filtreleme ve Zaman Sabiti Analizi
Dekuplaj ağında kullanılan 0.1 μF (100 nF) X7R kapasitörler, R = 1 Ω eşdeğer hat empedansı altında fc = 1 / (2 × π × 1 × 0.1 × 10

−6) = 1.59 MHz kesim frekansı oluşturarak yüksek frekanslı dijital anahtarlama gürültülerini toprağa aktarırken; 1 μF, 4.7 μF, 10 μF ve 100 μF dökme (bulk) kapasitörler 0.1 μs ile 50 μs arasındaki zaman sabitleriyle (τ = R × C) ani akım çekimlerinde gerilim çökmesini (voltage droop) önler [3], [8]. Bu kademeli filtreleme düzenlemesi sayesinde EMI/EMC direnci artırılmıştır.

Tablo 2: Kapasitörler (C1–C44) Teknik Seçim Gerekçeleri, EMI/EMC Rolleri ve Eksiksiz Matematiksel Hesaplamaları [3], (https://www.alldatasheet.com/datasheet-pdf/pdf/701384/STMICROELECTRONICS/AN4488.html) [4], (https://www.st.com/resource/en/application_note/an2867-guidelines-for-oscillator-design-on-stm8afals-and-stm32-mcusmpus-stmicroelectronics.pdf) [8]– (https://www.bosch-sensortec.com/media/boschsensortec/downloads/datasheets/bst-bmi270-ds000.pdf)[15]. (https://www.ti.com/lit/pdf/slla270)

Kod Değer / Kılıf / Tip

Bağlı Olduğu
Hat / Pin

Teknik Seçim
Gerekçesi ve
EMI/EMC Rolü

Matematiksel
Hesaplama ve
Doğrulama (Tam
İspat)

C1 10μF / 0805 / X7R

STM32 VBAT
(Pin 1)

Düşük ESR/ESL ile
VBAT hattında ani
akım taleplerini
karşılamak için
tercih edilmiştir.

R = 0.1 Ω için τ = R
× C = 0.1 × 10μF =
1.0 μs; Q = 3.3V ×
10μF = 33 μC.
C2, C3, C6, C7 | 0.1μF / 0603 / X7R

STM32 VDD
(Pin 19, 32, 48,
64)

Düşük parazitik
indüktans (ESL) ile
dijital çekirdek
anahtarlama
gürültülerini
süzmek için
seçilmiştir
(EMI/EMC
direncini artırır).

R = 1 Ω için fc

= 1 /
(2π × 1 × 0.1μF) =
1.59 MHz; Ctop = 4
× 0.1μF = 0.4 μF.

C4 0.1μF / 0603 / X7R

STM32 NRST
(Pin 7)

Reset hattında
mekanik buton
arkını (bounce) ve
EFT gürültülerini
süzmek için
seçilmiştir
(EMI/EMC
direncini artırır).

R2 = 10 kΩ ile τ =
R2 × C4 = 10⁴
×
10⁻⁷ = 1.0 ms; fc
= 1
/ (2π × 10kΩ ×
0.1μF) = 159.15 Hz.

C5 1μF / 0603 / X7R

STM32 VDDA
(Pin 13)

Analog besleme
hattında düşük/orta
frekans
dalgalanmalarını
bastırmak için
tercih edilmiştir.

R = 10 Ω için fc

= 1
/ (2π × 10 × 1μF) =
15.92 kHz; τ = 10
μs.

C8, C9 0.1μF /
0603 / X7R

VDDA (FB1
Öncesi ve
Sonrası)

FB1 ile Pi-tipi
yüksek frekanslı
analog izolasyon
filtresi oluşturmak
için seçilmiştir
(EMI/EMC
direncini artırır).

R = 1 Ω için fc

= 1 /
(2π × 1 × 0.1μF) =
1.59 MHz (FB1
Z100MHz = 600 Ω ile
>40 dB zayıflama).

C10 0.1μF / 0603 / X7R

J1 (Pi Zero W)
5V1 (Pin 2, 4)

5V1 besleme
hattındaki yüksek
frekanslı
anahtarlama
parazitlerini bypass
etmek için
seçilmiştir.

R = 1 Ω için fc

= 1 /
(2π × 1 × 0.1μF) =
1.59 MHz; Q = 5V ×
0.1μF = 0.5 μC.

C11 10μF / 0805 / X7R

J1 (Pi Zero W)
5V1 (Pin 2, 4)

Pi Zero W Wi-Fi/CPU ani akım
sıçramalarında
gerilim çökmesini
önlemek için 0805
kılıfta seçilmiştir.

R = 0.1 Ω için τ =
0.1 × 10μF = 1.0 μs;
Q = 5.0V × 10μF =
50 μC; E = 0.5 × C ×
V

2
= 125 μJ.
C12, C14 | 0.1μF / 0603 / X7R

BMI270
VDDIO (Pin 5)
ve VDD (Pin 8)

BMI270 dijital I/O
ve analog çekirdek
hatlarında HF
gürültü süzümü için
seçilmiştir.

R = 1 Ω için fc

=
1.59 MHz; τ = 0.1
μs; Q = 3.3V ×
0.1μF = 0.33 μC.

C13 1μF / 0603 / X7R

BMI270 VDD
(Pin 8, FB2
sonrası)

BMI270 ana
beslemesinde lokal
enerji rezervuarı
(bulk dekuplaj)
sağlamak için
seçilmiştir.

R = 0.5 Ω için τ =
0.5 × 1μF = 0.5 μs;
f
c

= 1 / (2π × 0.5 ×
1μF) = 318.3 kHz.

Kod Değer / Kılıf / Tip

Bağlı Olduğu
Hat / Pin

Teknik Seçim
Gerekçesi ve
EMI/EMC Rolü

Matematiksel
Hesaplama ve
Doğrulama (Tam
İspat)

C15 0.1μF / 0603 / X7R

MPU-6500
VDDIO (Pin 8)

20 MHz SPI2 I/O
geçiş gürültülerini
süzmek için tercih
edilmiştir.

R = 1 Ω için fc

=
1.59 MHz; 20
MHz'de XC

= 1 / (2π
× 20MHz × 0.1μF) =
0.08 Ω.

C16 0.1μF / 0603 / X7R

USB Type-C
(J2) VBUS (Pin
A4/B9)

USB kablosundan
gelen yüksek
frekanslı RF/EMI
parazitlerini girişte
toprağa süzmek
için seçilmiştir.

R = 1 Ω için fc

=
1.59 MHz; Q = 5.0V
× 0.1μF = 0.5 μC.

C17 4.7μF / 0805 / X7R

USB Type-C
(J2) VBUS (Pin
A4/B9)

USB sıcak takçıkar (hot-plug)
esnasında VBUS
çökmesini önlemek
ve USB-IF max 10
μF sınırına uymak
için seçilmiştir.

R = 0.5 Ω için τ =
0.5 × 4.7μF = 2.35
μs; CVBUS = 4.7μF +
0.1μF = 4.8 μF (≤ 10
μF USB-IF sınırı).

C18 0.1μF / 0603 / X7R

MPU-6500
REGOUT (Pin
10)

MPU-6500 dahili
LDO regülatörünün
faz marjını ve çıkış
kararlılığını
sağlamak için
seçilmiştir.

R = 1 Ω için τ = 1 ×
0.1μF = 0.1 μs; fc

=
1.59 MHz.

C19 1μF / 0603 / X7R

MPU-6500
VDD (Pin 13,
FB3 sonrası)

Jiroskop sürücü
katının düşük
frekanslı besleme
dalgalanmalarını
bastırmak için
seçilmiştir.

R = 0.5 Ω için τ =
0.5 × 1μF = 0.5 μs;
Q = 3.3V × 1μF =
3.3 μC.

C20 10nF / 0603 / X7R

MPU-6500
VDD (Pin 13,
FB3 sonrası)

Daha yüksek özrezonans frekansı
(SRF) ile >15 MHz
RF gürültülerini
süzmek için
seçilmiştir
(EMI/EMC
direncini artırır).

R = 1 Ω için fc

= 1 /
(2π × 1 × 10nF) =
15.92 MHz; 100
MHz'de XC

= 0.159
Ω.

C21,
C22

2.2μF /
0603 / X7R

STM32
VCAP_1 (Pin
31), VCAP_2
(Pin 47)

STM32 dahili 1.2V
çekirdek LDO
regülatörünün
kararlılığı için
düşük ESR (< 2 Ω)
gereksinimiyle
seçilmiştir.

R = 0.5 Ω için τ =
0.5 × 2.2μF = 1.1 μs;
Ctoplam_VCAP = 2 ×
2.2μF = 4.4 μF
(Vcore = 1.2V).

C23,
C24

0.1μF /
0603 / X7R

BMP280
VDDIO (Pin 8)
ve VDD (Pin 6)

Barometrik piezodirençli köprünün
besleme
gürültüsünü
süzmek için FB4
sonrasında
seçilmiştir.

R = 1 Ω için fc

=
1.59 MHz; FB4
(RDC = 0.45 Ω) ile
yüksek frekanslı L-C
bastırma sağlar.

C25,
C26

12pF /
0603 / C0G
(NP0)

Y1 8MHz
Kristal
(OSC_IN,
OSC_OUT)

Sıfıra yakın
sıcaklık katsayısı
(±30 ppm/°C) ile
10 pF hedef kristal
yük kapasitansını
sağlamak için C0G
seçilmiştir.

CL

= ((12 × 12) / (12
+ 12)) + Cstray(4pF)
= 6 pF + 4 pF = 10
pF.

C27,
C36,
C39

4.7nF /
0603 / C0G
(NP0)

J2 (USB), J5
(SD), J6 (DB25)
SHIELD

1 MΩ dirençlerle
(R27, R36, R58)
paralel bağlanarak
şasi yüksek
frekanslı ESD/EMI
akımlarını toprağa
süzmek için
seçilmiştir.

R = 1 MΩ için fc

= 1
/ (2π × 10⁶
× 4.7nF)
= 33.86 Hz (τ = 4.7
ms); 100 MHz'de XC
= 0.34 Ω.

C28 0.1μF / 0603 / X7R

U7
(74LVC1G86)
VCC (Pin 5)

XOR kapısının
anahtarlama
anındaki anlık şarj
talebini karşılamak
için seçilmiştir.

V = 3.3V için Q = C
× V = 0.1μF × 3.3V
= 0.33 μC; fc

= 1.59
MHz.

Kod Değer / Kılıf / Tip

Bağlı Olduğu
Hat / Pin

Teknik Seçim
Gerekçesi ve
EMI/EMC Rolü

Matematiksel
Hesaplama ve
Doğrulama (Tam
İspat)

C29 4.7μF / 0805 / X7R

U6
(LD39150DT33)
VI (Pin 1, +5V)

LDO girişindeki
düşük frekanslı
gerilim
dalgalanmalarını
sönümlemek için
seçilmiştir.

V = 5.0V için Q = C
× V = 4.7μF × 5.0V
= 23.5 μC; E = 0.5 ×
4.7μF × 5²
= 58.75
μJ.
C30, C32 | 0.1μF / 0603 / X7R

U6
(LD39150DT33)
VI ve VO

LDO giriş ve
çıkışında 100 MHz
bölgesindeki RF
parazitlere düşük
reaktans sunmak
için seçilmiştir.

f = 100 MHz için XC
= 1 / (2π × 10⁸
×
10⁻⁷) = 0.0159 Ω
(15.9 mΩ).

C31 10μF / 0805 / X7R

U6
(LD39150DT33)
VO (Pin 3,
3.3V_DIGI)

LD39150 kontrol
döngüsü kutup-sıfır
kararlılığını
sağlamak ve
salınımı önlemek
için seçilmiştir.

V = 3.3V için Q = C
× V = 10μF × 3.3V
= 33 μC; E = 0.5 ×
10μF × 3.3²
= 54.45
μJ.

C33 0.1μF / 0603 / X7R

U8
(SN65HVD230)
VCC (Pin 3)

1 Mbps CAN
diferansiyel
sürücüsünün
yüksek frekanslı
anahtarlama
gürültüsünü
bastırmak için
seçilmiştir.

V = 3.3V için Q =
0.33 μC; E = 0.5 ×
0.1μF × 3.3²
= 0.545
μJ; fc

= 1.59 MHz.

C34 4.7nF / 0603 / X7R

CAN Split
Terminasyon
Orta Noktası

R33 ve R34 (60.4
Ω) orta noktasından
ortak mod EMI
gürültülerini
toprağa süzmek
için seçilmiştir
(EMI/EMC
direncini artırır).

Rcm = 30.2 Ω için fc
= 1 / (2π × 30.2 ×
4.7nF) = 1.121 MHz
≈ 1.12 MHz.

C35 0.1μF / 0603 / X7R

D10
(PRTR5V0U2X)
VCC (Pin 4)

Raydan-raya (railto-rail) ESD diyot
dizisinin üst
kenetleme rayını
düşük empedansla
toprağa bağlamak
için seçilmiştir.

R = 1 Ω için fc

=
1.59 MHz; τ = 0.1
μs.

C37 100μF / 16V / SMD Elektrolitik

5V1 Ana Güç
Hattı (F2 ve D11
TVS yanı)

Harici 5V1
beslemesinde
yüksek enerji
depolayarak ani
yük değişimlerinde
dV/dt çökmesini
sınırlamak için
seçilmiştir.

R = 0.5 Ω için τ =
0.5 × 100μF = 50 μs;
E = 0.5 × 100μF ×
5

2
= 1.25 mJ.

C38 0.1μF / 0603 / X7R

DB25 (J6) 5V1
Hattı (C37/D11
yanı)

Dış konnektör güç
hattından
sızabilecek yüksek
frekanslı parazitleri
süzmek için
seçilmiştir.

R = 1 Ω için fc

=
1.59 MHz; 100
MHz'de XC

= 15.9
mΩ.

C40 0.1μF / 0603 / X7R

MicroSD (J5)
VDD (Pin 4,
FB5 sonrası)

21 MHz SD kart
erişimindeki
yüksek frekanslı
anahtarlama
gürültülerini
süzmek için
seçilmiştir.

R = 1 Ω için fc

=
1.59 MHz; 21
MHz'de XC

= 0.076
Ω.

C41 10μF / 0805 / X7R

MicroSD (J5)
VDD (Pin 4,
FB5 sonrası)

SD kart blok yazma
esnasındaki ~50–
100 mA ani akım
darbelerinde voltaj
çökmesini önlemek
için seçilmiştir.

R = 0.1 Ω için τ =
0.1 × 10μF = 1.0 μs;
ΔI = 100 mA
darbede ΔV = ΔI ×
Δt / C = 10 mV (@
1μs).

Kod Değer / Kılıf / Tip

Bağlı Olduğu
Hat / Pin

Teknik Seçim
Gerekçesi ve
EMI/EMC Rolü

Matematiksel
Hesaplama ve
Doğrulama (Tam
İspat)
C42, C43, C44 | 0.1μF / 0603 / X7R

U9, U10, U11
(74LVC1G125)
VCC (Pin 5)

Tampon
entegrelerinin hızlı
kenar geçişlerinde
besleme
sıçramalarını
(ground bounce)
önlemek için
seçilmiştir.

R = 1 Ω için fc

=
1.59 MHz; her bir
tampon için Q =
0.33 μC lokal şarj
sağlar.
5.2. Dirençler (R1 - R81): Pull-Up/Pull-Down, Empedans Eşleme ve Akım Sınırlama Analizi
CMOS dijital girişler boşta (floating/High-Z) bırakıldığında anten gibi davranarak elektromanyetik gürültü toplar, sahte kesmelere (spurious interrupts) ve eşik bölgesinde (VDD / 2) PMOS/NMOS transistörlerin aynı anda iletime geçmesiyle oluşan yıkıcı çapraz iletim akımlarına (shoot-through current) yol açar (AN4879) [5]. (https://www.st.com/resource/en/application_note/an4879-introduction-to-usb-hardware-and-pcb-guidelines-using-stm32-mcus-stmicroelectronics.pdf) Bu durumu engellemek için kullanılan 10 kΩ ve 100 kΩ dirençler hatları tanımlı lojik seviyelerde tutar ve EMI/EMC direncini artırır.

Tablo 3: Dirençler (R1–R81) Teknik Seçim Gerekçeleri, EMI/EMC Rolleri ve Eksiksiz Matematiksel Hesaplamaları [1]– (https://www.st.com/resource/en/datasheet/dm00037051.pdf)[15]. (https://www.ti.com/lit/pdf/slla270)

Kod Değer / Kılıf

Bağlı Olduğu Hat
/ Fonksiyon

Teknik Seçim
Gerekçesi ve
EMI/EMC Notu

Matematiksel
Hesaplama
(Akım, Güç,
Empedans - Tam
İspat)
R1, R5, R15 | 10kΩ /
| 0603

BMI270 CSB (R1),
OCSB (R5); MPU-6500 nCS (R15)
Pull-Up

MCU reset/boot
anında High-Z
iken SPI çip seçme
hatlarını Lojik-1'de
tutarak veriyolu
çakışmasını (bus
contention)
önlemek için
seçilmiştir.

V = 3.3V için I =
3.3 / 10000 = 0.33
mA; P = 3.3²
/
10000 = 1.089 mW
(≪ 100 mW).
R2 | 10kΩ /
| 0603

STM32 NRST (Pin
7) Harici Pull-Up

Dahili pull-up
(~40 kΩ) direncine
paralel destek
sağlayarak
EFT/ESD gürültü
marjını artırmak
için seçilmiştir
(EMI/EMC
direncini artırır).

V = 3.3V için I =
0.33 mA; P = 1.09
mW; Reş = (10k ×
40k) / 50k = 8.0
kΩ.

R3, R4,
R10, R19

10kΩ /
0603

BMI270 OSDO
(R3), INT1 (R4),
INT2 (R10); MPU-6500 INT (R19)
Pull-Down

Kullanılmayan
OIS pinini ve
aktif-yüksek
kesme hatlarını
boşta Lojik-0
(GND) seviyesine
sabitleyerek sahte
kesmeleri önlemek
için seçilmiştir.

V = 3.3V için I =
0.33 mA; P =
1.089 mW (aktif
darbe anında);
boşta P = 0 W.
R6, R7 | 10kΩ /
| 0603

SWCLK Pull-Down (R6) ve
SWDIO Pull-Up
(R7)

ARM Cortex-M4
SWD standardına
göre ST-LINK
bağlı değilken hata
ayıklama
pinlerinin
gürültüden
tetiklenmesini
önlemek için
seçilmiştir.

V = 3.3V için I =
0.33 mA; P =
1.089 mW.

Kod Değer / Kılıf

Bağlı Olduğu Hat
/ Fonksiyon

Teknik Seçim
Gerekçesi ve
EMI/EMC Notu

Matematiksel
Hesaplama
(Akım, Güç,
Empedans - Tam
İspat)
R8, R9 | 2.2kΩ /
| 0603

I2C1_SDA (R8) ve
I2C1_SCL (R9)
Pull-Up

400 kHz Fast-Mode I2C'de Cbus
= 150 pF altında
yükselme süresini
≤ 300 ns sınırında
tutmak için 2.2 kΩ
seçilmiştir
(UM10204).

t
r

= 0.8473 × 2200
× 150pF = 279.61
ns (≤ 300 ns); Isink
= 3.3V / 2.2kΩ =
1.5 mA; P = 4.95
mW.

R11, R16 10kΩ /
0603

BOOT0 (R11) ve
PB2/BOOT1 (R16)
Pull-Down

İşlemcinin kararlı
şekilde ana Flash
bellekten (0×0800
0000) önyükleme
yapması için
seçilmiştir.

V = 3.3V için I =
0.33 mA; P =
1.089 mW (JP1
kapatıldığında).
R12 | 0Ω (DNP) /
| 0603

PA8 (Pin 41) ↔
RC_IN_UART
(PD2) Köprü

RC_IN_UART
sinyalini opsiyonel
olarak PA8
(TIM1_CH1)
pinine
yönlendirmek için
bırakılmış DNP
(dizilmemiş)
dirençtir.

DNP durumunda I
= 0 mA, P = 0 W
(açık devre); 0 Ω
dizildiğinde Rs

<
50 mΩ.

R13, R14 100Ω /
0603

J1 Pi Zero W TXD
(R13) ve RXD
(R14) Seri Koruma

Pi Zero W ile
tampon entegreleri
arasında anlık aşırı
akımı sınırlamak
ve yansımaları
sönümlemek için
seçilmiştir.

3.3V kısa devrede
I = 3.3 / 100 = 33
mA; P = 3.3²
/ 100
= 108.9 mW
(normal çalışmada
I < 1 mA, P < 0.1
mW).

R17, R18 5.1kΩ /
0603

USB Type-C CC1
(R17) ve CC2
(R18) Pull-Down

USB-IF
standardına göre
kartı UFP/Sink
olarak tanıtıp 5V
VBUS beslemesini
donanımsal
başlatmak için %1
toleransla
seçilmiştir.

VCC = 0.418V
(900mA), 0.941V
(1.5A), 1.688V
(3.0A); Pmax =
1.688²
/ 5100 =
0.56 mW.

R20, R21,
R22, R23

330Ω /
0603

D2 (Mavi), D3
(Sarı), D4
(Kırmızı), D5
(Yeşil) LED Seri
Dirençleri

Durum
LED'lerinin
akımını güvenli
optik parlaklık
sınırında (1.5 mA
– 9.7 mA) tutmak
için seçilmiştir.

R20: I=1.52mA,
P=0.76mW; R21:
I=9.09mA,
P=27.3mW; R22:
I=9.70mA,
P=31.0mW; R23:
I=3.64mA,
P=4.37mW.

R24, R25 22Ω /
0603

USB_DN (R24) ve
USB_DP (R25)
Seri Empedans
Eşleme

Rdrv (23 Ω) ile
toplanarak 45 Ω
tek uçlu / 90 Ω
diferansiyel USB
2.0 empedans
eşleşmesi
sağlamak için
seçilmiştir
(EMI/EMC
direncini artırır).

Zse = 23 + 22 = 45
Ω; Zdiff

= 2 × 45 =
90 Ω (USB 2.0
90Ω ±%15
standardı ile tam
uyum).
R26 | 100Ω /
| 0603

OSC_OUT (Pin 6)
→ Y1 Kristal Seri
Sönümleme

8 MHz kristalin
sürüş gücünü
(Drive Level < 100
μW) sınırlayarak
aşırı sürülmeyi
(overdriving)
önlemek için
seçilmiştir
(AN2867).

DL = IRMS

2
× ESR
< 100 μW
sınırlandırılır; R26
+ C26 alçak
geçiren filtre
oluşturarak
harmonikleri
bastırır.

Kod Değer / Kılıf

Bağlı Olduğu Hat
/ Fonksiyon

Teknik Seçim
Gerekçesi ve
EMI/EMC Notu

Matematiksel
Hesaplama
(Akım, Güç,
Empedans - Tam
İspat)
R27, R36, R58 | 1MΩ /
| 0603

J2 (R27), J5 (R36),
J6 (R58) SHIELD -
GND İzolasyon
Dirençleri

Şasi ile dijital
toprak arasında
DC toprak
döngülerini
(ground loop)
kesmek ve statik
yükü deşarj etmek
için seçilmiştir
(EMI/EMC
direncini artırır).

5V altında I = 5 /
10⁶
= 5 μA; 2 kV
ESD yükünde τ =
1MΩ × 4.7nF =
4.7 ms içinde
güvenli statik
deşarj.

R28, R29,
R30

10kΩ,
1kΩ,
10kΩ /
0603

U7 XOR Giriş
Pull-Down (R28),
Çıkış Seri (R29),
JP2 Pull-Up (R30)

R28/R30 boşta
tanımlı seviye
sağlar; R29 (1kΩ)
ise MCU PD2
girişini aşırı akıma
karşı korur.

R29 (1kΩ): 3.3V
altında Imax = 3.3 /
1000 = 3.3 mA, P
= 10.89 mW;
R28/R30: I = 0.33
mA.

R31, R32 1kΩ,
10kΩ /
0603

Q1 MOSFET Gate
Seri (R31) ve Gate-GND Pull-Down
(R32)

R31 Gate şarj
akımını ve Ciss
çınlamasını
sınırlar; R32 reset
anında Q1'i
kesimde tutar.

R31: Ipeak = 3.3 /
1000 = 3.3 mA;
R31/R32 bölücü:
VGS = 3.3 × (10 /
11) = 3.0 V (>
VGS(th) = 1.05 V).

R33, R34,
R35

60.4Ω
(%1),
0Ω /
0603

CAN_L (R33),
CAN_H (R34)
Split Terminasyon;
U8 Rs (R35)

R33+R34 = 120.8
Ω ile 120 Ω CAN
kablo empedansını
eşlemek ve C34 ile
EMI süzmek için
seçilmiştir; R35
High-Speed modu
seçer.

Rdiff

= 120.8 Ω;
Rcm = 30.2 Ω;
f

c_CAN = 1.12
MHz; dominant
durumda
(Vdiff=2V) P = 2²
/
120.8 = 33.1 mW.

R37 -
R42

10kΩ /
0603

DB25 (J6)
TIM8_CH1..CH4
(R37–R40) ve
TIM3_CH3..CH4
(R41–R42) Pull-Down

MCU açılış/reset
anında PWM
çıkışlarını 0V
seviyesinde tutarak
motor/ESC'lerin
istem dışı
çalışmasını
önlemek için
seçilmiştir.

V = 3.3V için I =
3.3 / 10000 = 0.33
mA; P = 1.089
mW (kanal
başına).

R43, R44 22Ω /
0603

DB25 (J6)
I2C1_SDA (R43)
ve I2C1_SCL
(R44) Seri
Sönümleme

Dış konnektör I2C
hatlarında
çınlamayı
(ringing)
sönümlemek ve
D10 TVS diyodu
öncesi tepe ESD
akımını sınırlamak
için seçilmiştir.

3.3V kısa devrede
I = 3.3 / 22 = 150
mA; normal I2C
akımında (1.5 mA)
Vdrop = 1.5mA ×
22Ω = 33 mV
(ihmal edilebilir).
R45 | 100Ω /
| 0603

DB25 (J6 Pin 14)
USART3_RX Seri
Koruma

Dış ortamdan
gelen seri RX
hattında ESD ve
5V aşırı gerilim
akımını sınırlamak
için seçilmiştir.

5V aşırı gerilimde
I = 5 / 100 = 50
mA; P = 5²
/ 100 =
0.25 W (anlık
darbe D12 TVS ile
sönümlenir).
R46 - R57 | 150Ω /
| 0603

DB25 (J6) RC_IN,
TIM8_CH1..4,
TIM3_CH3..4,
USART2
(TX,RX,RTS,CTS),
USART3_TX Seri

Harici DB25
klemens kısa
devrelerinde akımı
MCU pin limitinin
(25 mA) altında
tutmak ve EMI
bastırmak için
seçilmiştir
(EMI/EMC
direncini artırır).

3.3V kısa devrede
I = 3.3 / 150 = 22.0
mA (< 25 mA
MCU sınırı); P =
3.3²
/ 150 = 72.6
mW (< 100 mW
0603 sınırı).

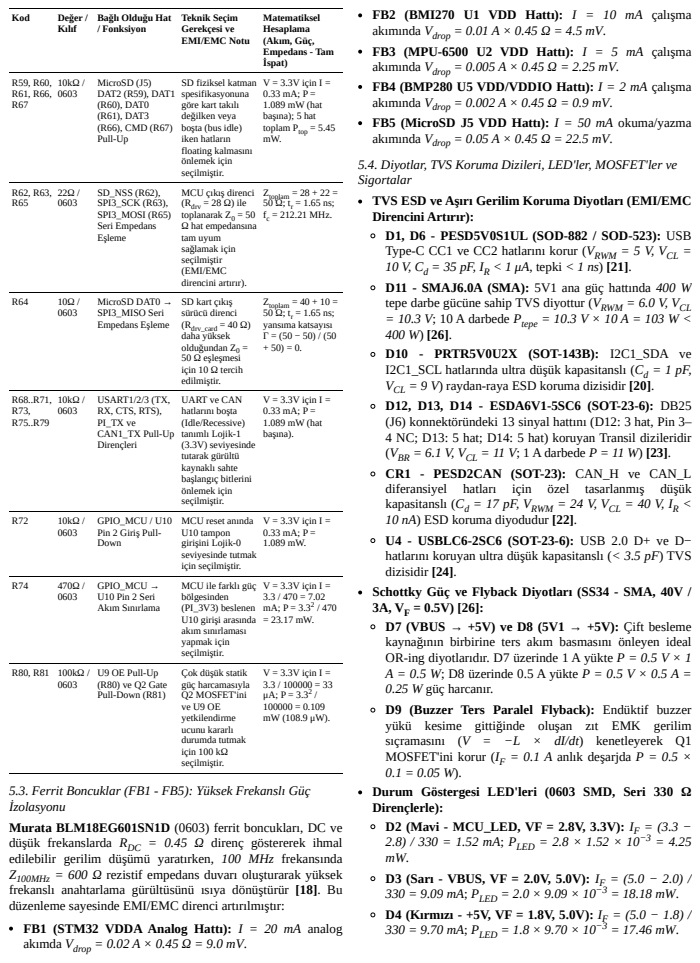
[picture p9: page 11]

FB2 (BMI270 U1 VDD Hattı): I = 10 mA çalışma
akımında Vdrop = 0.01 A × 0.45 Ω = 4.5 mV.
FB3 (MPU-6500 U2 VDD Hattı): I = 5 mA çalışma
akımında Vdrop = 0.005 A × 0.45 Ω = 2.25 mV.
FB4 (BMP280 U5 VDD/VDDIO Hattı): I = 2 mA çalışma
akımında Vdrop = 0.002 A × 0.45 Ω = 0.9 mV.
FB5 (MicroSD J5 VDD Hattı): I = 50 mA okuma/yazma
akımında Vdrop = 0.05 A × 0.45 Ω = 22.5 mV.
5.4. Diyotlar, TVS Koruma Dizileri, LED'ler, MOSFET'ler ve
Sigortalar
TVS ESD ve Aşırı Gerilim Koruma Diyotları (EMI/EMC
Direncini Artırır):
D1, D6 - PESD5V0S1UL (SOD-882 / SOD-523): USB
Type-C CC1 ve CC2 hatlarını korur (VRWM = 5 V, VCL =
10 V, Cd = 35 pF, IR < 1 μA, tepki < 1 ns) [21]. (https://assets.nexperia.com/documents/data-sheet/PESD5V0S1UL.pdf)
D11 - SMAJ6.0A (SMA): 5V1 ana güç hattında 400 W
tepe darbe gücüne sahip TVS diyottur (VRWM = 6.0 V, VCL
= 10.3 V; 10 A darbede Ptepe = 10.3 V × 10 A = 103 W <
D10 - PRTR5V0U2X (SOT-143B): I2C1_SDA ve
I2C1_SCL hatlarında ultra düşük kapasitanslı (Cd = 1 pF,
VCL = 9 V) raydan-raya ESD koruma dizisidir [20]. (https://www.nexperia.com/product/PRTR5V0U2X)
D12, D13, D14 - ESDA6V1-5SC6 (SOT-23-6): DB25
(J6) konnektöründeki 13 sinyal hattını (D12: 3 hat, Pin 3–
4 NC; D13: 5 hat; D14: 5 hat) koruyan Transil dizileridir
(VBR = 6.1 V, VCL = 11 V; 1 A darbede P = 11 W) [23]. (https://www.st.com/resource/en/datasheet/esda6v1-5sc6.pdf)
CR1 - PESD2CAN (SOT-23): CAN_H ve CAN_L
diferansiyel hatları için özel tasarlanmış düşük
kapasitanslı (Cd = 17 pF, VRWM = 24 V, VCL = 40 V, IR <
10 nA) ESD koruma diyodudur [22]. (https://assets.nexperia.com/documents/data-sheet/PESD2CAN.pdf)
U4 - USBLC6-2SC6 (SOT-23-6): USB 2.0 D+ ve D−
hatlarını koruyan ultra düşük kapasitanslı (< 3.5 pF) TVS
dizisidir [24]. (https://www.st.com/resource/en/datasheet/usblc6-2.pdf)

Schottky Güç ve Flyback Diyotları (SS34 - SMA, 40V /
D7 (VBUS → +5V) ve D8 (5V1 → +5V): Çift besleme
kaynağının birbirine ters akım basmasını önleyen ideal
OR-ing diyotlarıdır. D7 üzerinde 1 A yükte P = 0.5 V × 1
A = 0.5 W; D8 üzerinde 0.5 A yükte P = 0.5 V × 0.5 A =
0.25 W güç harcanır.
D9 (Buzzer Ters Paralel Flyback): Endüktif buzzer
yükü kesime gittiğinde oluşan zıt EMK gerilim
sıçramasını (V = −L × dI/dt) kenetleyerek Q1
MOSFET'ini korur (IF = 0.1 A anlık deşarjda P = 0.5 ×
Durum Göstergesi LED'leri (0603 SMD, Seri 330 Ω
Dirençlerle):
D2 (Mavi - MCU_LED, VF = 2.8V, 3.3V): IF = (3.3 −
2.8) / 330 = 1.52 mA; PLED = 2.8 × 1.52 × 10
D3 (Sarı - VBUS, VF = 2.0V, 5.0V): IF = (5.0 − 2.0) /
330 = 9.09 mA; PLED = 2.0 × 9.09 × 10
D4 (Kırmızı - +5V, VF = 1.8V, 5.0V): IF = (5.0 − 1.8) /
330 = 9.70 mA; PLED = 1.8 × 9.70 × 10

5.3. Ferrit Boncuklar (FB1 - FB5): Yüksek Frekanslı Güç
İzolasyonu
Murata BLM18EG601SN1D (0603) ferrit boncukları, DC ve
düşük frekanslarda RDC = 0.45 Ω direnç göstererek ihmal
edilebilir gerilim düşümü yaratırken, 100 MHz frekansında
Z100MHz = 600 Ω rezistif empedans duvarı oluşturarak yüksek
frekanslı anahtarlama gürültüsünü ısıya dönüştürür [18]. (https://pim.murata.com/en-global/pim/details/?partNum=BLM18EG601SN1%23) Bu
düzenleme sayesinde EMI/EMC direnci artırılmıştır:
FB1 (STM32 VDDA Analog Hattı): I = 20 mA analog
akımda Vdrop = 0.02 A × 0.45 Ω = 9.0 mV.

D5 (Yeşil - 3.3V_DIGI, VF = 2.1V, 3.3V): IF = (3.3 −
2.1) / 330 = 3.64 mA; PLED = 2.1 × 3.64 × 10

−3 = 7.64
mW.
N-Kanal MOSFET Sürücüler (Q1, Q2):
Q1 - AO3400A (SOT-23): Düşük eşik gerilimi (VGS(th) = 1.05 V) ve ultra düşük iletim direnci (RDS(on) = 33 mΩ @ VGS = 3.3 V) sebebiyle 5V Buzzer yükünü (J3) 3.3V MCU piniyle anahtarlamak için tercih edilmiştir [25]. (https://www.digikey.com/en/products/detail/alpha-omega-semiconductor-inc/AO3400A/1855772) ID = 30 mA akımda iletim kaybı P = (0.03)

2 × 0.033 =
0.0297 mW ≈ 0.029 mW.
Q2 - 2N7002 (SOT-23): Düşük kapı şarjı ve küçük sinyal evirme uygunluğu sebebiyle PI_3V3 varlığını algılayıp U9 OE pinini sürmek için tercih edilmiştir [27]. (https://assets.nexperia.com/documents/data-sheet/2N7002.pdf) R80 (100 kΩ) yük altında ID = 3.3 / 100000 = 33 μA ve RDS(on) = 3 Ω için kayıp güç P = (33 × 10

−6)

2 × 3 = 3.27 pW.
Yeniden Ayarlanabilir PTC Sigortalar (F1, F2):
F1 (1A PTC, USB VBUS Girişi): Ihold = 1 A, I

trip = 2 A,
Rinit = 0.1 Ω. 1 A nominal akımda Vdrop = 1.0 × 0.1 = 0.1 V ve P = 1.0

2 × 0.1 = 0.1 W.
F2 (2A PTC, DB25 5V1 Girişi): Ihold = 2 A, I

trip = 4 A,
Rinit = 0.05 Ω. 2 A nominal akımda Vdrop = 2.0 × 0.05 = 0.1 V ve P = 2.0

2 × 0.05 = 0.2 W.

5.5. Konnektörler, Anahtarlar, Jumper'lar ve Test Noktaları
J2 (USB Type-C 16-Pin): Pin A4/A9/B4/B9 (VBUS → F1), Pin A1/A12/B1/B12 (GND), Pin A5 (CC1 → R17 5.1 kΩ, D1), Pin B5 (CC2 → R18 5.1 kΩ, D6), Pin A6/B6 (D+ → U4, R25 22 Ω), Pin A7/B7 (D− → U4, R24 22 Ω), Pin S1 (SHIELD → R27 1 MΩ || C27 4.7 nF).
J3 (2-Pin Buzzer Header): Pin 1 (BUZZER_GND → Q1 Drain, D9 Anot), Pin 2 (+5V → D9 Katot).
J4 (5-Pin ST-LINK SWD Header): Pin 1 (GND), Pin 2 (SWCLK → PA14, R6), Pin 3 (SWDIO → PA13, R7), Pin 4 (NRST → Pin 7), Pin 5 (3.3V_DIGI → Hedef voltaj referansı).
J5 (MicroSD Soketi): Pin 1 (DAT2 → R59 10 kΩ), Pin 2 (DAT3/CD → R62 22 Ω, R66 10 kΩ), Pin 3 (CMD → R65 22 Ω, R67 10 kΩ), Pin 4 (VDD → FB5, C40 0.1 μF, C41 10 μF), Pin 5 (CLK → R63 22 Ω), Pin 6 (VSS → GND), Pin 7 (DAT0 → R64 10 Ω, R61 10 kΩ), Pin 8 (DAT1 → R60 10 kΩ), Pin 9–11 (SHIELD → R36 1 MΩ || C36 4.7 nF) [12]. (https://users.ece.utexas.edu/~valvano/EE345M/SD_Physical_Layer_Spec.pdf) J6 (DB25 Dış Arayüz Konnektörü): 5V1 güç girişi (Pin 1..3 → F2, D11, C37, C38), GND (Pin 4..8), USART2 (TX, RX, RTS, CTS - Pin 9..12), USART3 (TX, RX - Pin 13..14), CAN_H/CAN_L (Pin 15..16), I2C1 (SDA, SCL - Pin 17..18), RC_IN (Pin 19), TIM8_CH1..CH4 (Pin 20..23), TIM3_CH3..CH4 (Pin 24..25) ve SHIELD (Pin 0/PAD → R58 1 MΩ || C39 4.7 nF).
SW1 (Tactile Reset Butonu), JP1 (BOOT0 Jumper), JP2 (RC_IN XOR Jumper) ve TP1..TP4 Test Noktaları: SW1 (Rcontact < 100 mΩ) manuel reset sağlar; JP1 (varsayılan açık) kapatıldığında BOOT0 pinini 3.3 V'a çeker; JP2 3-pinli yapısıyla U7 XOR kapısının 1B girişini 3.3 V veya GND'ye yönlendirir; TP1 (3.3V_DIGI), TP2 (+5V), TP3 (GND) ve TP4 (5V1) ise < 0.5 pF parazitik yükle donanımsal doğrulama imkanı sunar.

VI. Şematik Düzeyde Elektromanyetik Uyumluluk (EMI/EMC)

Analizi ve Mühendislik Değerlendirmesi
Modern gömülü kontrol kartlarında yüksek hızlı dijital saat darbeleri (168 MHz ARM Cortex-M4 çekirdeği, 21 MHz SPI3, 20 MHz SPI2, 12 Mbps USB 2.0 ve 1 GHz Raspberry Pi Zero W RF/SoC modülü) ile hassas analog/MEMS sensörlerin (BMI270, MPU-6500, BMP280) aynı baskı devre kartı (PCB) üzerinde bulunması, şematik aşamadan başlayan disiplinli bir
Elektromanyetik | Girişim | (EMI) | bastırma | ve
Elektromanyetik Uyumluluk (EMC) bağışıklık mimarisi gerektirir [3], (https://www.alldatasheet.com/datasheet-pdf/pdf/701384/STMICROELECTRONICS/AN4488.html) [5]. (https://www.st.com/resource/en/application_note/an4879-introduction-to-usb-hardware-and-pcb-guidelines-using-stm32-mcus-stmicroelectronics.pdf) İncelenen şematik tasarımda EMI/EMC başarımını doğrudan belirleyen beş temel mühendislik katmanı aşağıda analitik olarak değerlendirilmiştir.
6.1. Güç Bütünlüğü (Power Integrity - PI), Çok Kademeli Dekuplaj ve Ferrit İzolasyon Mimarisi
CMOS entegrelerin durum geçişlerinde çektiği anlık anahtarlama akımları (dI/dt), güç dağıtım ağı (PDN) endüktansı (LPDN) üzerinde ΔVnoise = LPDN × (dI/dt) bağıntısına göre eşzamanlı anahtarlama gürültüsü (Simultaneous Switching Noise - SSN / Ground Bounce) oluşturur [3]. (https://www.alldatasheet.com/datasheet-pdf/pdf/701384/STMICROELECTRONICS/AN4488.html) Şemada bu mekanizmayı bastırmak için üç kademeli frekans bölüştürmeli dekuplaj ve yerel güç adası izolasyonu uygulanmıştır:
Çok Kademeli Kapasitif Dekuplaj Hiyerarşisi (Bulk + Mid-Band + RF Bypass): Harici girişte C37 (100 μF elektrolitik) düşük frekanslı (1 kHz – 500 kHz) enerji talebini karşılar. Alt sistemlerdeki 1 μF – 10 μF kapasitörler (C1, C5, C11, C13, C17, C19, C29, C31, C41) orta frekans bandında (500 kHz – 10 MHz) lokal şarj rezervuarı görevi görür. Her aktif entegrenin besleme bacağına doğrudan yerleştirilen 0603 kılıf 100 nF (C2, C3, C6, C7, C10, C12, C14–C16, C18, C23, C24, C28, C30, C32, C33, C35, C38, C40, C42– C44) seramik kapasitörler ise düşük parazitik seri endüktansları (ESL ≈ 0.5 nH) sayesinde 10 MHz – 50 MHz bandında düşük empedanslı yerel akım döngüsü sağlar. Özellikle MPU-6500 (U2) besleme hattında 1 μF (C19) ile paralel kullanılan 10 nF (C20) kapasitör, daha yüksek özrezonans frekansı (SRF > 60 MHz) ile yüksek frekanslı RF gürültülerini süzerek anti-rezonans tepelerini sönümler [3], (https://www.alldatasheet.com/datasheet-pdf/pdf/701384/STMICROELECTRONICS/AN4488.html) [9]. (https://product.tdk.com/en/search/sensor/mortion-inertial/imu/info?part_no=MPU-6500)
Ferrit Boncuklarla (FB1–FB5) Rezistif RF Sönümleme ve Güç Adası İzolasyonu: Saf indüktörlerin aksine Murata BLM18EG601SN1D ferrit boncukları, geçiş frekansının üzerinde (> 20 MHz) tamamen rezistif karakter (Z = R + jX içinde R ≫ X, 100 MHz'de 600 Ω) sergiler [18]. (https://pim.murata.com/en-global/pim/details/?partNum=BLM18EG601SN1%23) Bu sayede FB1 (STM32 VDDA), FB2 (BMI270), FB3 (MPU-6500), FB4 (BMP280) ve FB5 (MicroSD) noktalarında dekuplaj kapasitörleriyle oluşturulan L-tipi ve Pi-tipi (C8–FB1– C9/C5) filtre ağlarında yüksek kalite faktörlü (Q) LC çınlaması (ringing) yaşanmaz; yüksek frekanslı anahtarlama enerjisi ferrit çekirdekte doğrudan ısıya dönüştürülerek (absorptive filtering) hassas MEMS/ADC katları ana 3.3V_DIGI veriyolu gürültüsünden yalıtılır [3], (https://www.alldatasheet.com/datasheet-pdf/pdf/701384/STMICROELECTRONICS/AN4488.html) [18]. (https://pim.murata.com/en-global/pim/details/?partNum=BLM18EG601SN1%23)
LDO Regülatör Seçimi (LD39150DT33): Ana 3.3V regülatörü olarak anahtarlamalı (SMPS/Buck) regülatör yerine doğrusal LD39150DT33 (U6) seçilmesi, 100 kHz – 2 MHz bandında anahtarlama harmoniklerinin (conducted emission) hiç üretilmemesini sağlayarak IMU ve barometre taban gürültüsünü (noise floor) minimize etmiştir [13]. (https://www.st.com/resource/en/datasheet/ld39150.pdf)

6.2. Sinyal Bütünlüğü (SI), Kenar Dikliği (Slew-Rate) Kontrolü ve Işıma (Radiated Emission) Bastırma
Faraday yasasına göre bir iletim hattından uzaya yayılan elektrik alan şiddeti (Efar), akım döngüsü alanı (A), sinyal frekansının karesi (f

2
) ve geçiş kenarı dikliği (dI/dt ∝ 1/tr

) ile
doğru | orantılıdır. | Kare | dalga | sinyallerin | Fourier
spektrumundaki zarf eğrisi, birinci köşe frekansı fknee1 = 1 / (π × Thalf) değerinden sonra −20 dB/dekad, ikinci köşe frekansı fknee2 = 1 / (π × tr

) değerinden sonra ise −40 dB/dekad hızla düşer [5]: (https://www.st.com/resource/en/application_note/an4879-introduction-to-usb-hardware-and-pcb-guidelines-using-stm32-mcus-stmicroelectronics.pdf)
Seri Kaynak Sonlandırma (Series Source Termination) ile Yansıma ve Harmonik Süzümü: SPI3/MicroSD hatlarında kullanılan R62, R63, R65 (22 Ω) ve R64 (10 Ω) dirençleri, sürücü iç empedansını (28 Ω ve 40 Ω) karakteristik hat empedansına (Z0 = 50 Ω) eşleyerek yansıma katsayısını (Γ = (Zs − Z0
| | | | )/(Zs + Z0

) = 0) sıfırlar
[12]. (https://users.ece.utexas.edu/~valvano/EE345M/SD_Physical_Layer_Spec.pdf) Ayrıca bu dirençler hat kapasitansı (15 pF) ile fc = 212.21 MHz kesim frekanslı bir alçak geçiren filtre oluşturarak 21 MHz saatin 9. harmoniğinden (189 MHz) sonraki VHF/UHF ışıma bileşenlerini kaynağında bastırır. Dış Konnektör (DB25 - J6) Slew-Rate Sınırlaması: Kart dışına kablo demetiyle çıkan tüm PWM (TIM3, TIM8), UART (USART2, USART3) ve RC_IN hatlarına yerleştirilen R46–R57 (150 Ω) ve R43–R44 (22 Ω) seri dirençleri, uzun harici kabloların kapasitif yükünü (Ccable ≈ 50–200 pF) sürerken tepe şarj akımını (Ipeak ≤ 22 mA) ve dV/dt geçiş hızını yumuşatır. Bu sayede harici kabloların monopol/dipol anten gibi davranarak yaydığı (radiated emission) elektromanyetik parazit önemli ölçüde düşürülür [5]. (https://www.st.com/resource/en/application_note/an4879-introduction-to-usb-hardware-and-pcb-guidelines-using-stm32-mcus-stmicroelectronics.pdf)
Kristal Osilatör Harmonik Sınırlaması (R26 = 100 Ω): 8 MHz HSE kristalinin (Y1) OSC_OUT bacağındaki R26 = 100 Ω seri direnç, C26 (12 pF) ile birlikte evirici yükseltecin çıkışındaki karemsi dalgayı sinüsoidal forma yaklaştırır; böylece saat sinyalinin yüksek dereceli tek harmoniklerinin PCB yüzeyine kuple olması engellenir [4]. (https://www.st.com/resource/en/application_note/an2867-guidelines-for-oscillator-design-on-stm8afals-and-stm32-mcusmpus-stmicroelectronics.pdf)
6.3. Diferansiyel Hat Simetrisi ve Ortak Mod (Common-Mode) Gürültü Süzümü
Yüksek hızlı diferansiyel veriyollarında (CAN ve USB 2.0), sürücü asimetrileri veya dengesiz hat yükleri nedeniyle oluşan Ortak Mod (Common-Mode - CM) akımları, her iki iletkende aynı yönde akarak geniş bir dönüş döngüsü oluşturur ve en kritik EMI ışıma kaynağını teşkil eder [15]: (https://www.ti.com/lit/pdf/slla270)
CAN Bus Split Terminasyon (R33 = R34 = 60.4 Ω, C34 =

### 4.7 nF): Tek bir 120 Ω direnç yerine iki adet %1 toleranslı

60.4 Ω direncin orta noktasının C34 (4.7 nF) üzerinden toprağa bağlanması (Split Termination), diferansiyel sinyaller için yüksek empedans (Zdiff = 120.8 Ω) sunarken, ortak mod parazitleri için Rcm = 30.2 Ω ve fc_CM = 1.12 MHz kesim frekanslı düşük empedanslı bir toprak yolu oluşturur [15]. (https://www.ti.com/lit/pdf/slla270) Böylece harici CAN kablosundan sızan RF girişimleri (conducted immunity) alıcıya ulaşmadan şuntedilir ve dışarıya ortak mod ışıması yapılması önlenir. USB 2.0 Diferansiyel Empedans Uyumu (R24 = R25 = 22 Ω): D+ ve D− hatlarındaki simetrik 22 Ω dirençler (Zdiff = 90 Ω) ve eş-kapasitanslı USBLC6-2SC6 (U4) yapısı, faz kaymasını (skew) engelleyerek diferansiyel moddan ortak moda dönüşümü (mode conversion) bastırır [5], (https://www.st.com/resource/en/application_note/an4879-introduction-to-usb-hardware-and-pcb-guidelines-using-stm32-mcus-stmicroelectronics.pdf) [24]. (https://www.st.com/resource/en/datasheet/usblc6-2.pdf)

6.4. Çok Kademeli ESD, EFT ve Surge Bağışıklık Mimarisi (IEC 61000-4-2 / 4-4 / 4-5)
Kartın dış dünyaya açılan tüm konnektörlerinde (J2 USB Type-C, J5 MicroSD, J6 DB25), uluslararası elektromanyetik bağışıklık standartlarına (IEC 61000-4-2 ESD, IEC 61000-4-4 Elektriksel Hızlı Geçici Rejim/EFT ve IEC 61000-4-5 Yıldırım/Darbe) uyumlu iki kademeli koruma topolojisi (TVS Kenetleme + Seri Akım Sınırlama) uygulanmıştır: Birincil Kademe (Konnektör Girişinde Hızlı TVS Kenetleme): Dış darbe enerjisinin büyük kısmı, < 1 ns tepki süreli TVS diyotlarıyla (USB D+/D− için USBLC6-2SC6 U4 [24], (https://www.st.com/resource/en/datasheet/usblc6-2.pdf) USB CC1/CC2 için PESD5V0S1UL D1/D6 [21], (https://assets.nexperia.com/documents/data-sheet/PESD5V0S1UL.pdf) CAN için PESD2CAN CR1 [22], (https://assets.nexperia.com/documents/data-sheet/PESD2CAN.pdf) I2C için raydan-raya PRTR5V0U2X D10 [20], (https://www.nexperia.com/product/PRTR5V0U2X) DB25 GPIO/UART/PWM için ESDA6V1-5SC6 D12–D14 [23] (https://www.st.com/resource/en/datasheet/esda6v1-5sc6.pdf) ve 5V1 güç hattı için 400 W SMAJ6.0A D11 [26]) (https://industrialmonitordirect.com/blogs/knowledgebase/servo-motor-pwm-control-wiring-power-and-microcontroller-code) doğrudan toprağa aktarılır. Özellikle D10 (PRTR5V0U2X) entegresinin VCC bacağına eklenen C35 (0.1 μF) dekuplaj kapasitörü, pozitif ESD darbelerini düşük empedanslı bir acil deşarj yolu üzerinden toprağa kenetler [20]. (https://www.nexperia.com/product/PRTR5V0U2X)
İkincil | Kademe | (Seri | Dirençlerle Artık Akım
Sınırlaması): TVS diyotların kenetleme gerilimi (VCL ≈ 9 V – 11 V) ile MCU dahili ESD diyotlarının eşiği (VDD + 0.3 V = 3.6 V) arasında kalan gerilim farkı, TVS ile MCU pini arasına yerleştirilen seri dirençler (R43–R44 22 Ω, R45 100 Ω, R46–R57 150 Ω) üzerinde düşürülür. Örneğin DB25 hattında VCL = 11 V anında MCU pinine akan tepe darbe akımı I

residual = (11 V − 3.6 V) / 150 Ω = 49.3 mA seviyesine indirilerek CMOS latch-up (kilitleme) ve oksit delinmesi riski tamamen ortadan kaldırılır [5], (https://www.st.com/resource/en/application_note/an4879-introduction-to-usb-hardware-and-pcb-guidelines-using-stm32-mcus-stmicroelectronics.pdf) [23]. (https://www.st.com/resource/en/datasheet/esda6v1-5sc6.pdf)
Endüktif Geri Tepme (Flyback) ve Aşırı Akım Koruması: Buzzer (J3) bobinine ters paralel bağlanan D9 (SS34 Schottky) diyodu, Q1 MOSFET'i kesime gittiğinde oluşan yüksek −L(dI/dt) gerilim sıçramasını +5 V rayına kenetleyerek kart içi geniş bantlı elektromanyetik darbe oluşumunu engeller [26]. (https://industrialmonitordirect.com/blogs/knowledgebase/servo-motor-pwm-control-wiring-power-and-microcontroller-code) F1 (1 A) ve F2 (2 A) PTC sigortaları ise D11 TVS diyodu ile koordineli çalışarak sürekli aşırı gerilim/ters bağlantı durumunda termal açma (crowbar protection) sağlar.
6.5. Şasi Toprağı (SHIELD) İzolasyonu, Güç Bölgeleri Arası Yalıtım ve PCB Yerleşim (Layout) Kriterleri
Şasi (SHIELD) - Dijital Toprak (GND) RC Hibrit Bağlantısı (R27, R36, R58 = 1 MΩ || C27, C36, C39 = 4.7 nF): J2 (USB), J5 (MicroSD) ve J6 (DB25) metal konnektör gövdeleri (SHIELD), dijital toprağa doğrudan kısa devre edilmek yerine paralel 1 MΩ direnç ve 4.7 nF (C0G/NP0) kapasitör ağıyla bağlanmıştır. Bu topolojide 1 MΩ direnç DC ve şebeke frekanslarında (50/60 Hz) şasi üzerinden akabilecek yıkıcı toprak döngüsü (ground loop) akımlarını keserken biriken elektrostatik yükü güvenli bir zaman sabitiyle (τ = 4.7 ms) deşarj eder; paralel 4.7 nF C0G kapasitör ise yüksek frekanslı ESD ve RF ekranlama akımlarına çok düşük reaktans (100 MHz'de XC = 0.34 Ω) göstererek parazitlerin kart içine girmeden konnektör girişinde şasiye akmasını sağlar [5]. (https://www.st.com/resource/en/application_note/an4879-introduction-to-usb-hardware-and-pcb-guidelines-using-stm32-mcus-stmicroelectronics.pdf)
Kısmi Güç Kapatma (Partial Power-Down / Ioff) ve Floating Giriş Önleme: 74LVC1G125 (U9–U11) tamponları ve Q2 (2N7002) kontrol devresi, STM32 ile

Raspberry Pi Zero W güç bölgeleri arasında tam izolasyon sağlayarak kapalı modülün ESD diyotları üzerinden parazitik beslenmesini (back-powering) ve buna bağlı kararsız osilasyonları engeller [16]. Ayrıca tüm CS, kesme, UART, SWD ve PWM hatlarındaki pull-up/pull-down dirençleri ile MPU-6500 FSYNC (Pin 11) bacağının toprağa sabitlenmesi, yüksek empedanslı (High-Z) hatların RF anten gibi davranmasını önler [5], [9].

Tablo 4: Şematik Düzeyde Uygulanan EMI/EMC ve ESD Koruma Mekanizmalarının Alt Sistem Bazlı Sentez Matrisi [3]– (https://www.alldatasheet.com/datasheet-pdf/pdf/701384/STMICROELECTRONICS/AN4488.html)[5], (https://www.st.com/resource/en/application_note/an4879-introduction-to-usb-hardware-and-pcb-guidelines-using-stm32-mcus-stmicroelectronics.pdf) [15], (https://www.ti.com/lit/pdf/slla270) [18]– (https://pim.murata.com/en-global/pim/details/?partNum=BLM18EG601SN1%23) [24]. (https://www.st.com/resource/en/datasheet/usblc6-2.pdf)

Alt Sistem /
Arayüz

Şematik EMI/EMC &
Koruma
Komponentleri

Hedeflenen
Elektromanyetik
Tehdit / Bozulma
Mekanizması

Kantitatif Koruma
ve Filtreleme
Karakteristiği

Ana Güç
Girişi (+5V
VBUS &
5V1)

F1 (1A), F2 (2A) PTC;
D7, D8 (SS34); D11
(SMAJ6.0A); C16,
C17, C37, C38

Hot-plug inrush
akımı, ters polarite,
Surge/EFT darbeleri
ve düşük/yüksek
frekanslı hat
gürültüsü

VCL = 10.3 V (400 W
TVS); CVBUS = 4.8
μF (≤10 μF USB-IF);
5V1 hattında 100 μF
(C37) + 10 μF (C11)
enerji rezervuarı (τ =
50 μs).

MCU &
Sensör Güç
Adaları
(3.3V_DIGI
& VDDA)

U6 (LD39150DT33);
FB1–FB5
(BLM18EG601SN1D);
C2–C9, C12–C15,
C19–C24, C40–C41

Eşzamanlı
anahtarlama
gürültüsü (SSN),
dijitalden analoğa
kuplaj ve RF
besleme
dalgalanması

SMPS anahtarlama
gürültüsü sıfır
(LDO); 100 MHz'de
600 Ω rezistif ferrit
bariyeri; 1.59 MHz
ve 15.92 MHz (C20)
çok kademeli bypass.

SPI3 /
MicroSD
(J5) Yüksek
Hızlı
Veriyolu

R62, R63, R65 (22 Ω);
R64 (10 Ω); R59–R61,
R66–R67 (10 kΩ);
FB5; R36 || C36

21 MHz saat
harmonikleri,
empedans
uyumsuzluğu
yansımaları
(ringing) ve SD kart
yazma akım
darbeleri

Ztoplam = 50 Ω tam
empedans eşleşmesi
(Γ = 0); tr

= 1.65 ns
(%6.93 darbe oranı);
f
c

= 212.21 MHz (9.
harmoniğe kadar
temiz geçiş).

USB 2.0
Full-Speed
(J2 Type-C)

R24, R25 (22 Ω); U4
(USBLC6-2SC6); D1,
D6 (PESD5V0S1UL);
R17, R18 (5.1 kΩ);
R27 || C27

Diferansiyel
mod/ortak mod
dönüşümü, kablo
kaynaklı ESD
darbeleri ve şasi
toprak döngüsü

Zse = 45 Ω, Zdiff

= 90
Ω tam uyum; Cd

<
3.5 pF ultra düşük
kapasitanslı raydan-raya ESD kenetleme.

CAN Bus (1
Mbps - U8
& J6)

R33, R34 (60.4 Ω %1);
C34 (4.7 nF); CR1
(PESD2CAN); R35 (0
Ω); R78 (10 kΩ)

Bükümlü çift
kablodan
yayılan/gelen ortak
mod (CM) RF
parazitleri ve
endüstriyel
ESD/transient
darbeleri

Zdiff

= 120.8 Ω (ISO
11898-2 uyumu);
Rcm = 30.2 Ω ile
f

c_CM = 1.12 MHz
ortak mod alçak
geçiren EMI filtresi;
VCL = 40 V ESD.

I2C1 Harici
& Dahili
Veriyolu (U5
& J6)

R8, R9 (2.2 kΩ); R43,
R44 (22 Ω); D10
(PRTR5V0U2X); C35
(0.1 μF)

Kablo kapasitansı
kaynaklı yükselme
süresi bozulması,
çınlama ve harici
konnektör ESD
darbeleri

Cbus = 150 pF altında
t
r

= 279.61 ns (≤300
ns Fast-Mode sınırı);
Cd

= 1 pF parazitik
yük; kısa devre akımı
150 mA ile sınırlı.

DB25 (J6)
Harici
UART,
PWM &
RC_IN
Hatları

R46–R57 (150 Ω); R45
(100 Ω); D12–D14
(ESDA6V1-5SC6);
R37–R42 (10 kΩ); R58
|| C39

Uzun kablo anten
ışıması, harici kısa
devre, 5V aşırı
gerilim, ESD ve
açılışta istem dışı
motor tetiklenmesi

Kısa devre akımı 22
mA (<25 mA MCU
sınırı) ve P = 72.6
mW ile sınırlı; VCL =
11 V TVS sonrası
artık darbe akımı <50
mA.

Pi Zero W
(J1) - MCU
Güç
Bölgeleri
Arası Arayüz

U9, U10, U11
(74LVC1G125); Q2
(2N7002); R13, R14
(100 Ω); R74 (470 Ω);
R80, R81 (100 kΩ);
C42–C44

Kısmi güç
kesintisinde I/O
pinlerinden ters
besleme (back-powering) ve
sınırlar arası ground
bounce

PI_3V3 = 0V iken
U9 Hi-Z modunda
(Ioff

izolasyonu); seri
dirençlerle geçiş
akımları 7.02 mA –
33 mA aralığında
bastırılmış.

Alt Sistem /
Arayüz

Şematik EMI/EMC &
Koruma
Komponentleri

Hedeflenen
Elektromanyetik
Tehdit / Bozulma
Mekanizması

Kantitatif Koruma
ve Filtreleme
Karakteristiği

HSE 8 MHz
Kristal
Osilatör
(Y1) &
Buzzer (J3)

Y1 (8 MHz); C25, C26
(12 pF C0G); R26 (100
Ω); Q1 (AO3400A);
D9 (SS34); R31, R32

Kristal aşırı
sürülmesi
(overdriving), saat
harmonik ışıması ve
endüktif buzzer zıt
EMK darbesi

CL

= 10 pF tam
rezonans uyumu; DL
< 100 μW sürüş
koruması; D9 ile
−L(dI/dt) endüktif
sıçraması 0.5V'da
kenetlenir.

VII. Referanslar
1. STMicroelectronics, "STM32F405xx, STM32F407xx Arm Cortex-M4 32b MCU+FPU, 210DMIPS, up to 1MB Flash/192+4KB RAM, USB OTG HS/FS, Ethernet, 17 TIMs, 3 ADCs, 15 comm. interfaces & camera," Datasheet DS8626, Rev. 9, 2020.
[Çevrimiçi]. | | | | Erişim:
https://www.st.com/resource/en/datasheet/dm00037051.pdf
2. STMicroelectronics, | "RM0090 | Reference | Manual:
STM32F405/415, | STM32F407/417, | STM32F427/437 | and
STM32F429/439 advanced Arm-based 32-bit MCUs," Reference Manual DM00031020, Rev. 21, 2024. [Çevrimiçi]. Erişim: https://www.st.com/resource/ja/reference_manual/dm00031020 .pdf (https://www.st.com/resource/ja/reference_manual/dm00031020.pdf)
3. STMicroelectronics, "AN4488 Application Note: Getting started with STM32F4xxxx MCU hardware development," Application Note DM00115714 (ve AN2586 Hardware Development Guide),
Rev. | 8, | 2021. | [Çevrimiçi]. | Erişim:
https://www.alldatasheet.com/datasheetpdf/pdf/701384/STMICROELECTRONICS/AN4488.html (https://www.alldatasheet.com/datasheet-pdf/pdf/701384/STMICROELECTRONICS/AN4488.html) ve AN2586
4. STMicroelectronics, "AN2867 Application Note: Guidelines for oscillator design on STM8AF/AL/S and STM32 MCUs/MPUs," Application Note CD00221665, Rev. 16, 2023. [Çevrimiçi]. Erişim:
https://www.st.com/resource/en/application_note/an2867-guidelines-for-oscillator-design-on-stm8afals-and-stm32-mcusmpus-stmicroelectronics.pdf (https://www.st.com/resource/en/application_note/an2867-guidelines-for-oscillator-design-on-stm8afals-and-stm32-mcusmpus-stmicroelectronics.pdf)
5. STMicroelectronics, "AN4879 Application Note: Introduction to USB hardware and PCB guidelines using STM32 MCUs," Application Note DM00296349, Rev. 5, 2022. [Çevrimiçi]. Erişim: https://www.st.com/resource/en/application_note/an4879-introduction-to-usb-hardware-and-pcb-guidelines-usingstm32-mcus-stmicroelectronics.pdf (https://www.st.com/resource/en/application_note/an4879-introduction-to-usb-hardware-and-pcb-guidelines-using-stm32-mcus-stmicroelectronics.pdf)
6. Raspberry Pi Foundation, "Raspberry Pi Zero W Product Specification & Hardware Documentation," Cambridge, UK, 2017.
[Çevrimiçi]. | | | | Erişim:
https://www.raspberrypi.com/products/raspberry-pi-zero-w/
7. Broadcom Corporation, "BCM2835 ARM Peripherals Datasheet," Document BCM2835-ARM-Peripherals, Irvine, CA, USA, 2012.
[Çevrimiçi]. | | | | Erişim:
https://www.raspberrypi.org/app/uploads/2012/02/BCM2835-ARM-Peripherals.pdf (https://www.raspberrypi.org/app/uploads/2012/02/BCM2835-ARM-Peripherals.pdf)
8. Bosch Sensortec GmbH, "BMI270 Smart Ultra-Low Power Inertial Measurement Unit (IMU) Datasheet," Document BST-BMI270-DS000-02, Rev. 1.0, Reutlingen, Germany, 2020. [Çevrimiçi].
Erişim: | https://www.bosch-
sensortec.com/media/boschsensortec/downloads/datasheets/bst-bmi270-ds000.pdf (https://www.bosch-sensortec.com/media/boschsensortec/downloads/datasheets/bst-bmi270-ds000.pdf)
9. TDK InvenSense, "MPU-6500 Six-Axis (Gyro + Accelerometer) MEMS MotionTracking Device Product Specification," Document PS-MPU-6500A-00, Rev. 1.3, San Jose, CA, USA, 2020.
[Çevrimiçi]. | | | | Erişim:
https://product.tdk.com/en/search/sensor/mortioninertial/imu/info?part_no=MPU-6500 (https://product.tdk.com/en/search/sensor/mortion-inertial/imu/info?part_no=MPU-6500)

10. Bosch Sensortec GmbH, "BMP280 Digital Pressure Sensor Datasheet," Document BST-BMP280-DS001-19, Rev. 1.19,
Reutlingen, | | Germany, | 2018. | [Çevrimiçi]. | Erişim:
https://www.boschsensortec.com/media/boschsensortec/downloads/datasheets/bst-bmp280-ds001.pdf (https://www.bosch-sensortec.com/media/boschsensortec/downloads/datasheets/bst-bmp280-ds001.pdf)
11. NXP Semiconductors, "UM10204: I2C-bus specification and user manual," User Manual UM10204, Rev. 7.0, Eindhoven,
Netherlands, | 2021. | [Çevrimiçi]. | Erişim:
https://www.nxp.com/documents/user_manual/UM10204.pdf
12. SD Association, "SD Specifications Part 1: Physical Layer Simplified Specification," Version 3.01, San Ramon, CA, USA,
2010. | [Çevrimiçi]. | Erişim:
https://users.ece.utexas.edu/~valvano/EE345M/SD_Physical_Layer_Spec.pdf (https://users.ece.utexas.edu/~valvano/EE345M/SD_Physical_Layer_Spec.pdf)
13. STMicroelectronics, "LD39150 1.5 A ultra low drop BiCMOS voltage regulator," Datasheet DocID13186, Rev. 6, Geneva,
Switzerland, | 2017. | [Çevrimiçi]. | Erişim:
https://www.st.com/resource/en/datasheet/ld39150.pdf
14. Texas | Instruments, | "SN65HVD230, | SN65HVD231,
SN65HVD232 3.3-V CAN Transceivers," Datasheet SLOS346O,
Dallas, | TX, | USA, | 2018. | [Çevrimiçi]. | Erişim:
https://www.danomsk.ru/upload/iblock/507/129640_88c1a087ef 01c473a9fb6655ddb2a31a.pdf (https://www.danomsk.ru/upload/iblock/507/129640_88c1a087ef01c473a9fb6655ddb2a31a.pdf)
15. Texas Instruments, "Controller Area Network Physical Layer Requirements," Application Report SLLA270, Dallas, TX, USA, 2008. [Çevrimiçi]. Erişim: https://www.ti.com/lit/pdf/slla270
16. Nexperia B.V., "74LVC1G125 Single bus buffer/line driver; 3-state," Product Data Sheet, Rev. 14, Nijmegen, Netherlands, 2021.
[Çevrimiçi]. | Erişim:
https://assets.nexperia.com/documents/datasheet/74LVC1G125.pdf (https://assets.nexperia.com/documents/data-sheet/74LVC1G125.pdf)
17. Nexperia B.V., "74LVC1G86 2-input EXCLUSIVE-OR gate," Product Data Sheet, Rev. 12, Nijmegen, Netherlands, 2021.
[Çevrimiçi]. | Erişim:
https://assets.nexperia.com/documents/datasheet/74LVC1G86.pdf (https://assets.nexperia.com/documents/data-sheet/74LVC1G86.pdf)
18. Murata Manufacturing Co., Ltd., "BLM18EG601SN1D Chip Ferrite Bead for GHz Band Noise Suppression Product Specification," Kyoto, Japan, 2022. [Çevrimiçi]. Erişim: https://pim.murata.com/en-global/pim/details/?partNum=BLM18EG601SN1%23 (https://pim.murata.com/en-global/pim/details/?partNum=BLM18EG601SN1%23)
19. Abracon LLC, "ABM8 Series Ultra Miniature Ceramic SMD Quartz Crystal (8.000 MHz, CL = 10 pF) Datasheet," Spicewood,
TX, | USA, | 2021. | [Çevrimiçi]. | Erişim:
https://abracon.com/Resonators/abm8.pdf
20. Nexperia B.V., "PRTR5V0U2X Ultra low capacitance double railto-rail ElectroStatic Discharge (ESD) protection diode," Product Specification, Nijmegen, Netherlands, 2020. [Çevrimiçi]. Erişim: https://www.nexperia.com/product/PRTR5V0U2X
21. Nexperia B.V., "PESD5V0S1UL Ultra low capacitance unidirectional ESD protection diode in SOD523," Product Data Sheet, Nijmegen, Netherlands, 2019. [Çevrimiçi]. Erişim: https://assets.nexperia.com/documents/datasheet/PESD5V0S1UL.pdf (https://assets.nexperia.com/documents/data-sheet/PESD5V0S1UL.pdf)
22. Nexperia B.V., "PESD2CAN CAN bus protection diode in SOT23," Product Data Sheet, Nijmegen, Netherlands, 2020.
[Çevrimiçi]. | Erişim:
https://assets.nexperia.com/documents/datasheet/PESD2CAN.pdf (https://assets.nexperia.com/documents/data-sheet/PESD2CAN.pdf)
23. STMicroelectronics, "ESDA6V1-5SC6 Quadruple Transil array for ESD protection," Datasheet CD00001362, Rev. 6, 2019.
[Çevrimiçi]. | Erişim:
https://www.st.com/resource/en/datasheet/esda6v1-5sc6.pdf
24. STMicroelectronics, "USBLC6-2SC6 Very low capacitance ESD protection for high speed data lines," Datasheet CD00050750, Rev.
6, | 2020. | [Çevrimiçi]. | Erişim:
https://www.st.com/resource/en/datasheet/usblc6-2.pdf
25. Alpha & Omega Semiconductor, "AO3400A 30V N-Channel MOSFET (SOT-23) Technical Specification," Sunnyvale, CA,
USA, | 2020. | [Çevrimiçi]. | Erişim:
https://www.digikey.com/en/products/detail/alpha-omegasemiconductor-inc/AO3400A/1855772 (https://www.digikey.com/en/products/detail/alpha-omega-semiconductor-inc/AO3400A/1855772)
26. Industrial Monitor Direct, "Power Protection, Flyback Snubbing (SS34 Schottky & SMAJ6.0A TVS), and Microcontroller PWM
Interface | Reference," | Technical | Knowledgebase, | 2023.
[Çevrimiçi]. | Erişim:
https://industrialmonitordirect.com/blogs/knowledgebase/servo -motor-pwm-control-wiring-power-and-microcontroller-code (https://industrialmonitordirect.com/blogs/knowledgebase/servo-motor-pwm-control-wiring-power-and-microcontroller-code)
27. Nexperia B.V., "2N7002 60 V, 300 mA N-channel Trench MOSFET," Product Data Sheet, Rev. 9, Nijmegen, Netherlands,
2021. | | [Çevrimiçi]. | | Erişim:
https://assets.nexperia.com/documents/data-sheet/2N7002.pdf
