ard4kocabiyik/kocapilot-kapgan-multi-domain-FCU/kocapilot Kapgan.step

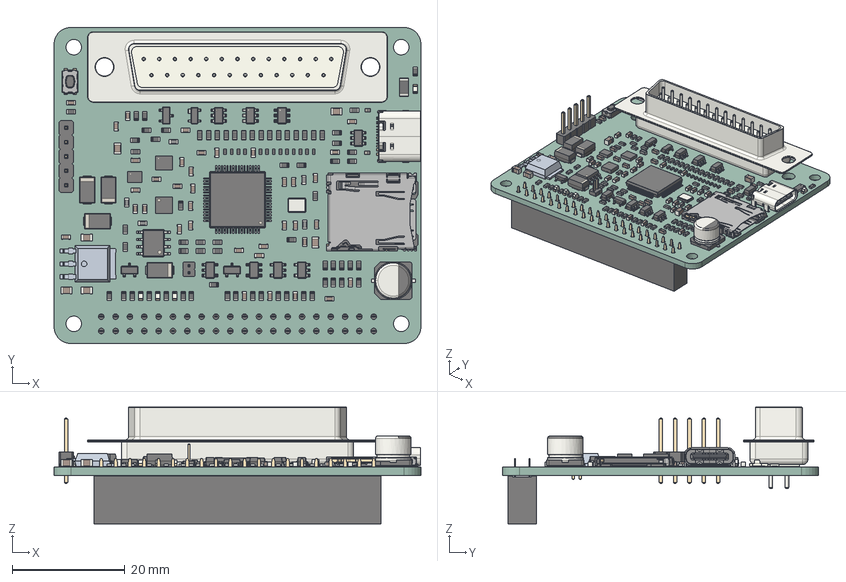
[picture p10: CAD file, 2026-11-02]
kocapilot Kapgan.step
65.0 x 56.0 x 20.7 mm
SOT-23-6 x 4
kocapilot Kapgan 1.2.1
L_0603_1608Metric x 5
R_0603_1608Metric x 68
C_0805_2012Metric x 6
SOT-23-5 x 4
LQFP-64_10x10mm_P0.5mm
D_SMA x 4
LED_0603_1608Metric x 4
SOT-23
C_0603_1608Metric x 37
R_0402_1005Metric x 13
SOIC-8_3.9x4.9mm_P1.27mm
DSUB-25_Pins_Vertical_P2.77x2.84mm_MountingHoles
USB_C_Receptacle_GCT_USB4105-xx-A_16P_TopMnt_Horizontal
D_SOD-882 x 2
LGA-14_3x2.5mm_P0.5mm_LayoutBorder3x4y
PinHeader_1x02_P1.27mm_Vertical
SOT-143
microSD_HC_Hirose_DM3AT-SF-PEJM5
SOT-23-3 x 2
PinHeader_1x05_P2.54mm_Vertical
Bosch_LGA-8_2x2.5mm_P0.65mm_ClockwisePinNumbering
Fuse_1206_3216Metric
Crystal_SMD_3225-4Pin_3.2x2.5mm
SW_Push_1P1T_NO_CK_KMR2
CP_Elec_6.3x5.4
QFN-24-1EP_3x3mm_P0.4mm_EP1.75x1.6mm
PinSocket_2x20_P2.54mm_Vertical
kocapilot Kapgan_PCB
