ard4kocabiyik/kocapilot-kapgan-multi-domain-FCU/kapgan_case.step

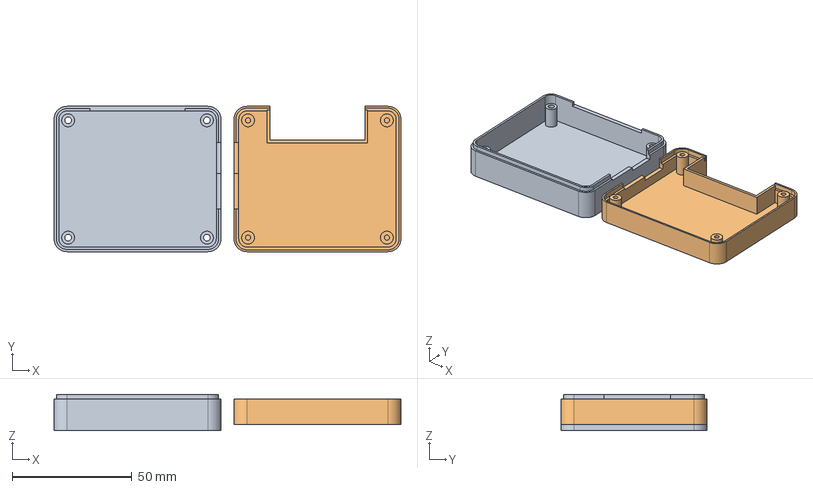
[picture p11: CAD file, 2026-11-02]
kapgan_case.step
145.0 x 60.8 x 15.2 mm
