ard4kocabiyik/kocapilot-kapgan-multi-domain-FCU/Ltspice/Kapgan_Guc_Agi.asc

B_BMI270: bi; I=V(PROF_BMI)*fcmos(V(V3V3_BMI),1.5)
B_BMP280: bi; I=V(PROF_BMP)*fcmos(V(V3V3_BMP),1.5)
B_CAN: bi; I=V(PROF_CAN)*fcmos(V(V3V3),2.6)
B_FAULT: bi; I=V(PROF_FLT)*min(max(V(V3V3),0)/0.5,1)
B_I2C_PU: bi; I=V(PROF_I2C)*max(V(V3V3),0)/3.3
B_IMU_IO: bi; I=0.3m*fcmos(V(V3V3),1.5)
B_LOGIC: bi; I=0.1m*fcmos(V(V3V3),1.2)
B_MCU: bi; I=(V(PROF_MCU)+V(PROF_MCUFL))*fcmos(V(V3V3),1.75)
B_MPU6500: bi; I=V(PROF_MPU)*fcmos(V(V3V3_MPU),1.6)
B_PI3V3: bv; V=min(3.3,max(V(V5V1)-0.25,0))*0.5*(1+tanh((V(V5V1)-4.0)/0.05))
B_RPI: bi; I=fpsu(V(PROF_PI1)+V(PROF_PI2),V(V5V1),4.0)
B_SDCARD: bi; I=V(PROF_SD)*fcmos(V(V3V3_SD),2.7)
B_U7U11: bi; I=50u*fcmos(V(PI_3V3),1.2)
B_VDDA: bi; I=1.6m*fcmos(V(V3V3_VDDA),1.7)
C3: cap; {100n*K100N}; Rser=30m Lser=0.6n
C4: cap; {4.7u*K4U7}; Rser=6m Lser=0.75n
C5: cap; {100n*K100N}; Rser=30m Lser=0.6n
C6: cap; {10u*K10U5}; Rser=4m Lser=0.8n
C7: cap; {100n*K100N}; Rser=30m Lser=0.6n
C8: cap; {10u*K10U3}; Rser=4m Lser=0.8n
C9: cap; {10u*K10U3}; Rser=4m Lser=0.8n
C10: cap; {100n*K100N}; Rser=30m Lser=0.6n
C11: cap; {100n*K100N}; Rser=30m Lser=0.6n
C12: cap; {100n*K100N}; Rser=30m Lser=0.6n
C13: cap; {1u*K1U}; Rser=12m Lser=0.6n
C14: cap; {100n*K100N}; Rser=30m Lser=0.6n
C16: cap; {100n*K100N}; Rser=30m Lser=0.6n
C17: cap; {1u*K1U}; Rser=12m Lser=0.6n
C18: cap; {100n*K100N}; Rser=30m Lser=0.6n
C20: cap; {100n*K100N}; Rser=30m Lser=0.6n
C21: cap; {100n*K100N}; Rser=30m Lser=0.6n
C22: cap; {100n*K100N}; Rser=30m Lser=0.6n
C23: cap; {100n*K100N}; Rser=30m Lser=0.6n
C24: cap; {100n*K100N}; Rser=30m Lser=0.6n
C26: cap; {10n*K100N}; Rser=60m Lser=0.6n
C27: cap; {100n*K100N}; Rser=30m Lser=0.6n
C28: cap; {100n*K100N}; Rser=30m Lser=0.6n
C29: cap; {4.7u*K4U7}; Rser=6m Lser=0.75n
C30: cap; {100n*K100N}; Rser=30m Lser=0.6n
C31: cap; {100n*K100N}; Rser=30m Lser=0.6n
C33: cap; {100n*K100N}; Rser=30m Lser=0.6n
C34: cap; {100n*K100N}; Rser=30m Lser=0.6n
C36: cap; {1u*K1U}; Rser=12m Lser=0.6n
C38: cap; {10u*K10U3}; Rser=4m Lser=0.8n
C40: cap; {100n*K100N}; Rser=30m Lser=0.6n
C41: polcap; 100µ; V=16 Rser=0.34 Lser=3n Rpar=1Meg
C42: cap; {100n*K100N}; Rser=30m Lser=0.6n
C44: cap; {100n*K100N}; Rser=30m Lser=0.6n
D1: zener; SMAJ6V0A temp={TAMB}
D8: LED; LED_RED temp={TAMB}
D9: LED; LED_BLUE temp={TAMB}
D10: LED; LED_GREEN temp={TAMB}
D11: LED; LED_AMBER temp={TAMB}
D_U9: zener; USBLC6_Z temp={TAMB}
FB1: ind; 1µ; Rser={RFB} Rpar=650 Cpar=1.2p
FB2: ind; 1µ; Rser={RFB} Rpar=650 Cpar=1.2p
FB3: ind; 1µ; Rser={RFB} Rpar=650 Cpar=1.2p
FB4: ind; 1µ; Rser={RFB} Rpar=650 Cpar=1.2p
FB5: ind; 1µ; Rser={RFB} Rpar=650 Cpar=1.2p
L_BUZ: ind; 2m; Rser=80 Rpar=5k
L_EXTCBL: ind; 0.5µ; Rser=15m
L_USBCBL: ind; 1µ; Rser=0
Q1: nmos; AO3400A temp={TAMB}
R5: res; 1k
R7: res; 10k
R36: res; 330
R37: res; 330
R43: res; 330
R81: res; 330
R_BEC: res; {RBEC}
R_PI3: res; 0.05
R_USBH: res; {RUSB}
S_GPIO_LED: sw; SW_GPIO
V_BUZPWM: voltage; PULSE(0 3.3 40m 20n 20n 185u 370u 216)
V_EXT: voltage; PWL(0 0 1m 0 3m {VEXT*EXT_ON})
V_LEDCTL: voltage; PULSE(0 3.3 20m 1u 1u 25m 50m)
V_USB: voltage; PWL(0 0 2m 0 2.1m {VUSB*USB_ON})
VP_BMI: voltage; PULSE(0.69m 0.95m 3m 5u 5u 100u 625u)
VP_BMP: voltage; PULSE(3u 1.12m 4m 10u 10u 6.4m 25m)
VP_CAN: voltage; PULSE(10m 17m 5m 50n 50n 110u 1m)
VP_FAULT: voltage; PULSE(0 {IFAULT} 125m 1u 1u 5m 1)
VP_I2C: voltage; PULSE(0 3m 2.5m 100n 100n 40u 1m)
VP_MCU: voltage; PULSE(60m 115m 5m 2u 2u 80u 1m)
VP_MCUFL: voltage; PULSE(0 25m 15m 10u 10u 2m 50m)
VP_MPU: voltage; PULSE(3.2m 3.8m 3m 5u 5u 100u 1m)
VP_PI_BASE: voltage; PWL(0 0 3m 0 4m 1.6 60m 1.6 60.05m 2.6 110m 2.6 110.05m 1.6)
VP_PI_WIFI: voltage; PULSE(0 1.2 10m 20u 20u 1.5m 10m)
VP_SD: voltage; PWL REPEAT FOREVER (0 1m 30m 1m 30.005m 150m 30.2m 150m 30.205m 90m 33m 90m 33.005m 1m 50m 1m) ENDREPEAT
XD2: schottky; SS34_ET
XD3: schottky; SS34_ET
XD7: schottky; SS34_ET
XF1: res; PTC_2920_2A
XF2: res; PTC_1206_1A1
Named nets: VEXT_SRC, 0, EXT1, VIN_DB25, V5V1, V5, VUSB_SRC, USB1, VBUS, VBUS_F, BUZ_D, BUZ_G, BUZ_PWM, V3V3, PI3_INT, PI_3V3, PROF_PI1, PROF_PI2, LED_CTL, N_GPIO, PROF_MCU, PROF_MCUFL, PROF_CAN, PROF_I2C, PROF_FLT, V3V3_VDDA, V3V3_BMI, PROF_BMI, V3V3_MPU, PROF_MPU, V3V3_BMP, PROF_BMP, V3V3_SD, PROF_SD
1) GIRIS-1: DB25 (J2) harici 5V / BEC  ->  F1 (2A PTC)  ->  5V1  ->  D2 (SS34)  ->  +5V
BEC kaynagi + kablo + konnektor modeli; 5V1 dogrudan RPi Zero 2W'yi (J1) besler. D2/D3 = diyot-VEYA.
BEC (EXT_ON ile ac/kapa)
TVS SMAJ6.0A
elektrolitik
2) GIRIS-2: USB-C (J4) VBUS  ->  F2 (1A PTC)  ->  D3 (SS34)  ->  +5V
USB host portu + kablo enduktansi (sicak takma ani akimi). U9 USBLC6 VBUS kenetlemesi, D11 amber VBUS LED'i.
USB host (USB_ON)
U9 USBLC6 VBUS-GND
VBUS LED
3) +5V RAYI: LED, buzzer (J3, Q1 AO3400A, D7 flyback), U1 LD39150DT33 LDO  ->  3V3_DIGI
LDO alt devresi kutu icindeki XU1 satiri ile cagrilir (pinler: IN=V5, OUT=V3V3, GND=0).
+5V LED
MCU PC13 (BUZZER) -> R5 -> Q1 kapisi (2.7 kHz)
J3 buzzer (2mH/80R)
U1  LD39150DT33
1.5A ULDO (DPAK)
XU1 V5 V3V3 0 LD39150_33
IN
OUT
GND
4) RPi ZERO 2W (J1, 5V1 rayindan) + PI_3V3 (Pi'nin kendi 3V3 cikisi)
Sabit-guc yuk: P/V, PMIC UVLO ~4.0V. Profil = VP_PI_BASE (W) + VP_PI_WIFI (W).
Pi PMIC 3V3 (V5V1'e bagli)
5) 3V3_DIGI: STM32F405 (U2) VDD dekuplaji, MCU akimi, LED'ler
B_MCU = MCU cekirdek+cevre akimi (profil VP_MCU + flash yazma VP_MCUFL), D9 mavi LED MCU pini (PB4) ile surulur.
MCU_LED (GPIO)
3V3 LED
6) 3V3_DIGI: CAN (SN65HVD230), I2C pull-up'lar, sensor VDDIO'lari, lojik, ariza senaryosu
7) FERRIT FILTRELI KOLLAR (BLM18EG601SN1D): VDDA, BMI270, MPU-6500, BMP280, microSD
STM32 VDDA
BMI270 VDD (U5)
MPU-6500 VDD (U4)
BMP280 (U3)
microSD (J5)
SD yazma: 200us 150mA tepe, 90mA mesgul, 20ms periyot
KAPGAN FCU - GUC AGI SIMULASYONU  (kocapilot Kapgan.kicad_sch + Kapgan.kicad_sch, rev1.0)
Tum modeller dosyaya gomulu (alt kisimda). Yukler = ters yonlu akim kaynaklari (B-I). Tum dosya ASCII.
NE OGRENMEK ISTIYORSAN -> NASIL ELDE EDERSIN  (Run'dan sonra; .meas sonuclari: View > SPICE Error Log  [Ctrl+L])
Ray gerilimi (3V3, +5V, 5V1, SD...)  : rayin teline tikla  ->  V(V3V3), V(V5), V(V5V1), V(V3V3_SD), V(V3V3_VDDA)...
Ray min/max/ortalama, LDO payi       : Ctrl+L -> V3V3_MIN, V3V3_MAX, V3V3_AVG, V5_MIN, LDO_HEADROOM_MIN, VSD_MIN, VDDA_PP
Bir elemanin akimi                   : eleman govdesine tikla (akim probu)  ->  I(C9), I(R43), I(L_BUZ) ...
Bir elemanin harcadigi guc           : Alt + eleman govdesine tikla
Kaynaktan cekilen akim / tepe        : I(V_EXT), I(V_USB) (negatif = kaynaktan cikan); Ctrl+L -> I_EXT_PK, I_USB_PK, I_*_AVG
LDO cikis akimi / jonksiyon sicakligi: V(XU1:ip) [1V = 1A],  V(XU1:tj) [1V = 1 C];  Ctrl+L -> I_LDO_PK, I_LDO_AVG, TJ_LDO
PTC sigorta sicakligi                : V(XF1:X1:t), V(XF2:X1:t) [C];  ~125 C'de acar.  Ctrl+L -> T_F1, T_F2
Bir dalga formunun ortalama/RMS'i     : plot penceresinde iz adina Ctrl + sol tik
Dalgalanma spektrumu (FFT)            : plot penceresinde sag tik > View > FFT
Sicaklik taramasi                     : asagidaki ';.step param TAMB ...' satirinda ';' yerine '!' yaz
Sadece USB / sadece BEC               : .param satirinda EXT_ON=0 veya USB_ON=0
3V3 kisa devre / ariza testi          : IFAULT=1.5 (125 ms'de 5 ms boyunca 1.5 A)
Yuk profilini degistirmek             : VP_* kaynaklarinin degeri = yuk akimi [A] (RPi icin guc [W])
Kondansator DC-bias / ESR             : deger {100n*K100N} -> K... carpani .param'da; ESR/ESL sag tik > SpiceLine (Rser/Lser)
Uzun termal analiz (PTC/LDO isinmasi) : .tran 0 30 0 1m  (birkac dakika surer)
Ag isimleri: VEXT_SRC/EXT1/VIN_DB25 = BEC tarafi, V5V1 = 5V1, VBUS/VBUS_F = USB, V5 = +5V, V3V3 = 3.3V_DIGI, PROF_* = yuk profili sinyalleri (devre degil).
Eleman adlari KiCad referanslaridir (rev1.0, 2026-10-23). V_/R_BEC/L_*CBL/B_*/VP_* = semada olmayan kaynak, kablo ve yuk modelleri.
SIMULASYON AYARLARI
.param TAMB=25 EXT_ON=1 USB_ON=1 VEXT=5.2 VUSB=5.0 RBEC=30m RUSB=0.25 IFAULT=0 K100N=0.95 K1U=0.85 K4U7=0.55 K10U5=0.45 K10U3=0.62 RFB=0.25
TAMB=25 : ortam sicakligi [C]
EXT_ON=1 : DB25 (BEC) 5V girisi: 1=var 0=yok
USB_ON=1 : USB-C VBUS: 1=var 0=yok
VEXT=5.2 : BEC cikis gerilimi [V]
VUSB=5.0 : USB host gerilimi [V]
RBEC=30m : BEC cikis direnci [Ohm]
RUSB=0.25 : USB port + 1m kablo direnci [Ohm]
IFAULT=0 : 3V3 ariza akimi (125ms'de 5ms) [A]
K100N=0.95 : 100nF X7R DC-bias carpani
K1U=0.85 : 1uF X5R @3.3V carpani
K4U7=0.55 : 4.7uF X5R @5V carpani
K10U5=0.45 : 10uF X5R @5V carpani
K10U3=0.62 : 10uF X5R @3.3V carpani
RFB=0.25 : BLM18EG601SN1D DCR [Ohm]
.tran 0 150m 0 2u
.step param TAMB list -40 25 85     <- sicaklik taramasi: bastaki ';' yerine '!' yaz
.step param EXT_ON list 0 1         <- sadece-USB / harici giris karsilastirmasi
OLCUMLER (.meas) - sonuclar Ctrl+L
.meas TRAN V3V3_MIN MIN V(V3V3) FROM 20m TO 150m
.meas TRAN V3V3_MAX MAX V(V3V3) FROM 20m TO 150m
.meas TRAN V3V3_AVG AVG V(V3V3) FROM 20m TO 150m
.meas TRAN VSD_MIN MIN V(V3V3_SD) FROM 20m TO 150m
.meas TRAN VDDA_PP PP V(V3V3_VDDA) FROM 20m TO 150m
.meas TRAN V5_MIN MIN V(V5) FROM 20m TO 150m
.meas TRAN V5V1_MIN MIN V(V5V1) FROM 20m TO 150m
.meas TRAN LDO_HEADROOM_MIN MIN V(V5)-V(V3V3) FROM 20m TO 150m
.meas TRAN I_LDO_PK MAX V(XU1:ip) FROM 20m TO 150m
.meas TRAN I_LDO_AVG AVG V(XU1:ip) FROM 20m TO 150m
.meas TRAN TJ_LDO MAX V(XU1:tj)
.meas TRAN I_EXT_PK MAX -I(V_EXT) FROM 5m TO 150m
.meas TRAN I_USB_PK MAX -I(V_USB) FROM 2m TO 150m
.meas TRAN I_USB_AVG AVG -I(V_USB) FROM 20m TO 150m
.meas TRAN I_EXT_AVG AVG -I(V_EXT) FROM 20m TO 150m
.meas TRAN T_F1 MAX V(XF1:X1:t)
.meas TRAN T_F2 MAX V(XF2:X1:t)
.meas TRAN VBUZ_PK MAX V(BUZ_D) FROM 40m TO 125m
MODEL KUTUPHANESI (gomulu) - LD39150, PTC, SS34, TVS, LED, AO3400A, fonksiyonlar
*======================================================================
* KAPGAN FCU - GUC AGI MODEL KUTUPHANESI (LTspice'a gomulu)
*======================================================================
* Ortak global parametre: TAMB (ortam sicakligi, C). Tum termal
* modeller ve diyot/LED/MOSFET instance sicakliklari TAMB'a baglidir.
*
* --- LD39150DT33 : 1.5A ULDO, BiCMOS, DPAK ---------------------------
* Datasheet (ST DocID13159): Vdrop 200mV@1.5A / 40mV@300mA (typ),
* 400mV max (-40..125C); Iq 1mA typ, 2.5mA max; Isc 3A;
* line reg 0.04% (VO+1..6V); load reg 0.06%/A typ; SVR 65dB@120Hz;
* TSD 170C, histerezis 10C; Rth j-c 8C/W.
* Model: termal Foster agi (Tj dugumu), Tj'ye bagli Ron/Vref/Ilim/Iq,
* PI hata yukselteci + anti-windup, gecis elemani kutbu, UVLO, soft-start,
* termal kapanma (histerezisli), PMOS govde diyotu (OUT->IN ters akim).
.subckt LD39150_33 IN OUT GND params: VNOM=3.3 RON25=0.133 ISC=3.0 IQ0=1m
+ RJC=8 CJC=0.03 RCA=50 CCA=1.2 TSD=170 TSDH=10 UVLO=2.25 TSS=150u
+ GM=30 FI=3k GDC=505 FP=1Meg KLINE=2.35e-4 TC1=20u TC2=-0.6u
* -- termal (V(tj) = jonksiyon sicakligi, C)
Bamb amb 0 V={TAMB}
Rjc tj tc {RJC}
Cjc tj tc {CJC}
Rca tc amb {RCA}
Cca tc amb {CCA}
Bpd 0 tj I=max(V(IN,OUT),0)*V(ip)+max(V(IN,GND),0)*V(ig)
* -- termal kapanma (histerezisli Schmitt)
Btsd ts0 0 V=0.5*(1+tanh((V(tj)-({TSD}-{TSDH}*V(tsd)))/0.5))
Rts ts0 tsd 1k
Cts tsd 0 1n
* -- UVLO (100mV histerezis) ve etkinlestirme
Ben en0 0 V=0.5*(1+tanh((V(IN,GND)-({UVLO}-0.1*V(en)))/0.02))*(1-V(tsd))
Ren en0 en 1k
Cen en 0 1n
* -- referans: sicaklik egrisi + hat regulasyonu + soft-start
Bvt vt 0 V={VNOM}*(1+{TC1}*(V(tj)-25)+{TC2}*(V(tj)-25)*(V(tj)-25))*(1+{KLINE}*(V(IN,GND)-4.3))*V(en)+V(GND)
Rss vt vr 1k
Css vr 0 {TSS/1k}
* -- PI hata yukselteci (A/V), anti-windup, sizinti -> sonlu DC kazanc (yuk reg.)
Berr err 0 V=V(vr)-V(OUT)
Bint 0 vi I=1u*({GM}*6.2832*{FI}*V(err)-1e6*(V(raw)-V(isat))-V(vi)*6.2832*{FI}/({GDC}/{GM}-1)-(1-V(en))*1e6*V(vi))
Cint vi 0 1u
Braw raw 0 V={GM}*V(err)+V(vi)
Bsat isat 0 V=max(min(V(raw),{ISC}*(1-0.002*(V(tj)-25))),0)*V(en)
Rgp isat ig1 1k
Cgp ig1 0 {1/(6.2832*FP*1k)}
* -- gecis elemani: dropout bolgesinde Ron(Tj), regulasyonda akim kaynagi
Bip 0 ip I=(0.5*(V(IN,OUT)+sqrt(V(IN,OUT)*V(IN,OUT)+1e-6)))/({RON25}*(1+0.004*(V(tj)-25)))*tanh(max(V(ig1),0)*{RON25}*(1+0.004*(V(tj)-25))/(0.5*(V(IN,OUT)+sqrt(V(IN,OUT)*V(IN,OUT)+1e-6))+1m))
Rip ip 0 1
Cip ip 0 1n
Bpass IN OUT I=V(ip)
Dbody OUT IN DBODY_LD
.model DBODY_LD D(IS=1e-11 N=1.1 RS=0.05 CJO=200p)
* -- toprak (quiescent) akimi: Iq(Tj) + dropout'ta artis
Big ig 0 V=1u+V(en)*({IQ0}*(1+0.003*(V(tj)-25))+0.8m*0.5*(1+tanh((0.05-V(IN,OUT)+V(ip)*{RON25})/0.02)))
Bgnd IN GND I=V(ig)
Cini IN GND 100p
Couti OUT GND 50p
Rbl OUT GND 2Meg
.ends LD39150_33
*
* --- POLIMER PTC (elektro-termal, latching) ---------------------------
* R(T)=R0*(1+TCR*(T-25))*(1+KJ/(1+exp(-(T-TTRIP)/2.5)))
* I^2R isinmasi -> RTH/CTH -> T ; TTRIP civarinda 4 dekad sicrama.
.subckt PTC_POLY A B params: R0=0.1 RTH=195 CTH=9m TTRIP=125 KJ=1e4 TCR=0.008
Bamb amb 0 V={TAMB}
Br A B I=V(A,B)/({R0}*(1+{TCR}*(V(t)-25))*(1+{KJ}/(1+exp(-(V(t)-{TTRIP})/2.5))))
Bp 0 t I=V(A,B)*V(A,B)/({R0}*(1+{TCR}*(V(t)-25))*(1+{KJ}/(1+exp(-(V(t)-{TTRIP})/2.5))))
Rth t amb {RTH}
Cth t amb {CTH}
.ends PTC_POLY
* F1: 1206 1.1A-hold sinifi (MF-MSMF110 benzeri) ; F2: 2920 2A-hold sinifi
.subckt PTC_1206_1A1 A B
X1 A B PTC_POLY R0=0.10 RTH=195 CTH=9m
.ends PTC_1206_1A1
.subckt PTC_2920_2A A B
X1 A B PTC_POLY R0=0.045 RTH=111 CTH=0.15
.ends PTC_2920_2A
*
* --- SS34 Schottky (40V/3A, SMA) ELEKTRO-TERMAL -----------------------
* Vf: ~0.31V@0.1A, 0.41V@1A, 0.50V@3A (25C); Ir: ~5uA@40V/25C,
* ~2mA@100C; Eg=0.69 (Schottky), XTI=2; oz isinma Rth(j-a)=85C/W.
.subckt SS34_ET A K params: IS0=5u N=1.2 RS=0.03 XTI=2 EG=0.69 BV=46 IBV=0.5m RTH=85 CTH=0.05 CJ=250p
Bamb amb 0 V={TAMB}
Rrs A ja {RS}
Bd ja K I={IS0}*exp({XTI}/{N}*ln((V(t)+273.15)/298.15)+{EG}/({N}*8.617e-5*(V(t)+273.15))*((V(t)+273.15)/298.15-1))*(exp(min(V(ja,K)/({N}*8.617e-5*(V(t)+273.15)),40))*(1+max(V(ja,K)/({N}*8.617e-5*(V(t)+273.15))-40,0))-1)-{IBV}*exp(min((-V(ja,K)-{BV})/(1.5*8.617e-5*(V(t)+273.15)),40))
Cj ja K {CJ}
Bp 0 t I=max(V(A,K)*V(A,ja)/{RS},0)
Rth t amb {RTH}
Cth t amb {CTH}
.ends SS34_ET
*
* --- TVS / ESD diyotlari ---------------------------------------------
* SMAJ6.0A: VR=6.0V, VBR 6.67..7.37V@10mA, VC=10.3V@38.8A, alpha(VBR)~5.7e-4/C
.model SMAJ6V0A D(IS=2e-12 N=1.1 RS=0.012 BV=6.95 IBV=10m NBV=1.4 TBV1=5.7e-4 CJO=3.2n VJ=0.8 M=0.4 TT=50n EG=1.11 XTI=3)
* USBLC6-2SC6 VBUS-GND zener yolu: VBR~6.1V, sizinti <150nA@5V
.model USBLC6_Z D(IS=1e-14 N=1.05 RS=0.5 BV=6.1 IBV=1m NBV=1.2 TBV1=6e-4 CJO=60p)
*
* --- LED'ler (0603, tipik egriler; tempco ~-2..-3mV/C) ---------------
.model LED_BLUE  D(IS=1.3e-21 N=2.595 RS=8 EG=1.38 XTI=3 CJO=40p BV=5 IBV=10u)
.model LED_GREEN D(IS=2.34e-21 N=1.769 RS=6 EG=1.36 XTI=3 CJO=30p BV=5 IBV=10u)
.model LED_RED   D(IS=2.22e-18 N=2.012 RS=5 EG=1.14 XTI=3 CJO=30p BV=5 IBV=10u)
.model LED_AMBER D(IS=8.43e-19 N=2.012 RS=5 EG=1.14 XTI=3 CJO=30p BV=5 IBV=10u)
*
* --- AO3400A N-MOSFET (30V, 28mOhm@4.5V, Vth~1.05V, Ciss~630p) -------
.model AO3400A VDMOS(Rg=1.5 Vto=1.05 Kp=19 Lambda=0.02 Rd=8m Rs=5m Rb=12m Cgdmax=200p Cgdmin=30p Cgs=550p Cjo=110p M=0.5 Is=2e-12 N=1.1 BV=30 Ksubthres=0.1 Bex=-1.5 Vtotc=-3m mfg=AOS Vds=30 Ron=28m Qg=7n)
*
* --- MCU GPIO cikis kati (yuksek-taraf ~40 Ohm, yumusak gecis) --------
.model SW_GPIO SW(Ron=40 Roff=100Meg Vt=1.65 Vh=-0.3)
*
* --- yuk davranis fonksiyonlari --------------------------------------
* CMOS dijital yuk: akim ~ V (C*V*f), POR esigi altinda ~0
.func fcmos(v,von) {max(v,0)/3.3*0.5*(1+tanh((v-von)/0.08))}
* SMPS/PMIC girisi: sabit guc, UVLO altinda kapali
.func fpsu(p,v,vuv) {p/max(v,3.5)*0.5*(1+tanh((v-vuv)/0.05))}
